worxbend/macropad/pcb/netlist.txt

+1V1           U1.6 U1.23 U1.39 U1.50 C2.1 C5.1 C8.1 C12.1 L1.1 C13.1 TP6.1
+3V3           U1.1 U1.11 U1.20 U1.30 U1.38 U1.45 U1.44 U1.49 U1.53 U1.54 C1.1 C3.1 C4.1 C6.1 C7.1 C9.1 C10.1 C32.1 C33.1 C11.1 R1.2 R3.1 U2.5 C18.1 TP5.1 R10.2 R11.2 R12.2 R13.2 J2.3 C19.1 U4.1 U4.5 C20.1
+5V            F1.2 U2.1 U2.3 C17.1 TP4.1 U4.6 C21.1 C22.1 C23.1 LED1.2 C24.1 LED2.2 C25.1 LED3.2 C26.1 LED4.2 C27.1 LED5.2 C28.1 LED6.2 C29.1 LED7.2 C30.1 LED8.2 C31.1
BOOT           R4.2 SW13.1
CC1            J1.A5 R5.1
CC2            J1.B5 R6.1
DISP_CS        U1.36 J2.5
DISP_MOSI      U1.35 J2.1
DISP_SCK       U1.34 J2.2
ENC_L_A        U1.41 ENC1.A R10.1
ENC_L_B        U1.42 ENC1.B R11.1
ENC_L_SW       U1.43 ENC1.S1
ENC_R_A        U1.2 ENC2.A R12.1
ENC_R_B        U1.3 ENC2.B R13.1
ENC_R_SW       U1.4 ENC2.S1
GND            U1.47 U1.61 C1.2 C2.2 C3.2 C4.2 C5.2 C6.2 C7.2 C8.2 C9.2 C10.2 C32.2 C33.2 C11.2 C12.2 C13.2 C14.2 Y1.2 Y1.4 C15.2 C16.2 SW14.2 SW13.2 TP3.1 J1.A1 J1.A12 J1.B1 J1.B12 J1.S1 R5.2 R6.2 U3.2 U2.2 C17.2 C18.2 SW1.2 SW2.2 SW3.2 SW4.2 SW5.2 SW6.2 SW7.2 SW8.2 SW9.2 SW10.2 SW11.2 SW12.2 ENC1.C ENC1.S2 ENC1.MP ENC2.C ENC2.S2 ENC2.MP J2.4 C19.2 U4.2 C20.2 C21.2 C22.2 C23.2 LED1.4 C24.2 LED2.4 C25.2 LED3.4 C26.2 LED4.4 C27.2 LED5.4 C28.2 LED6.4 C29.2 LED7.4 C30.2 LED8.4 C31.2 H1.1
KEY0           U1.33 SW1.1
KEY1           U1.32 SW2.1
KEY10          U1.12 SW11.1
KEY11          U1.10 SW12.1
KEY2           U1.7 SW3.1
KEY3           U1.5 SW4.1
KEY4           U1.31 SW5.1
KEY5           U1.29 SW6.1
KEY6           U1.9 SW7.1
KEY7           U1.8 SW8.1
KEY8           U1.28 SW9.1
KEY9           U1.27 SW10.1
LED_D0         R9.2 LED1.1
LED_D1         LED1.3 LED2.1
LED_D2         LED2.3 LED3.1
LED_D3         LED3.3 LED4.1
LED_D4         LED4.3 LED5.1
LED_D5         LED5.3 LED6.1
LED_D6         LED6.3 LED7.1
LED_D7         LED7.3 LED8.1
LED_DATA_3V3   U1.13 U4.3
LED_DATA_5V    U4.4 R9.1
QSPI_SS        U1.60 R4.1
RUN            U1.26 R3.2 SW14.1
SWCLK          U1.24 TP1.1
SWDIO          U1.25 TP2.1
USB_DM         U1.51 R7.2
USB_DP         U1.52 R8.2
USB_D_N        J1.A7 J1.B7 U3.1 U3.6 R7.1
USB_D_P        J1.A6 J1.B6 U3.3 U3.4 R8.1
VBUS           J1.A4 J1.A9 J1.B4 J1.B9 U3.5 F1.1
VREG_AVDD      U1.46 C14.1 R1.1
VREG_LX        U1.48 L1.2
XIN            U1.21 Y1.1 C15.1
XOUT           U1.22 R2.1
XTAL_DRIVE     Y1.3 C16.1 R2.2
