worxbend/macropad/cad/exports/drawings/general_arrangement.pdf

## TOP

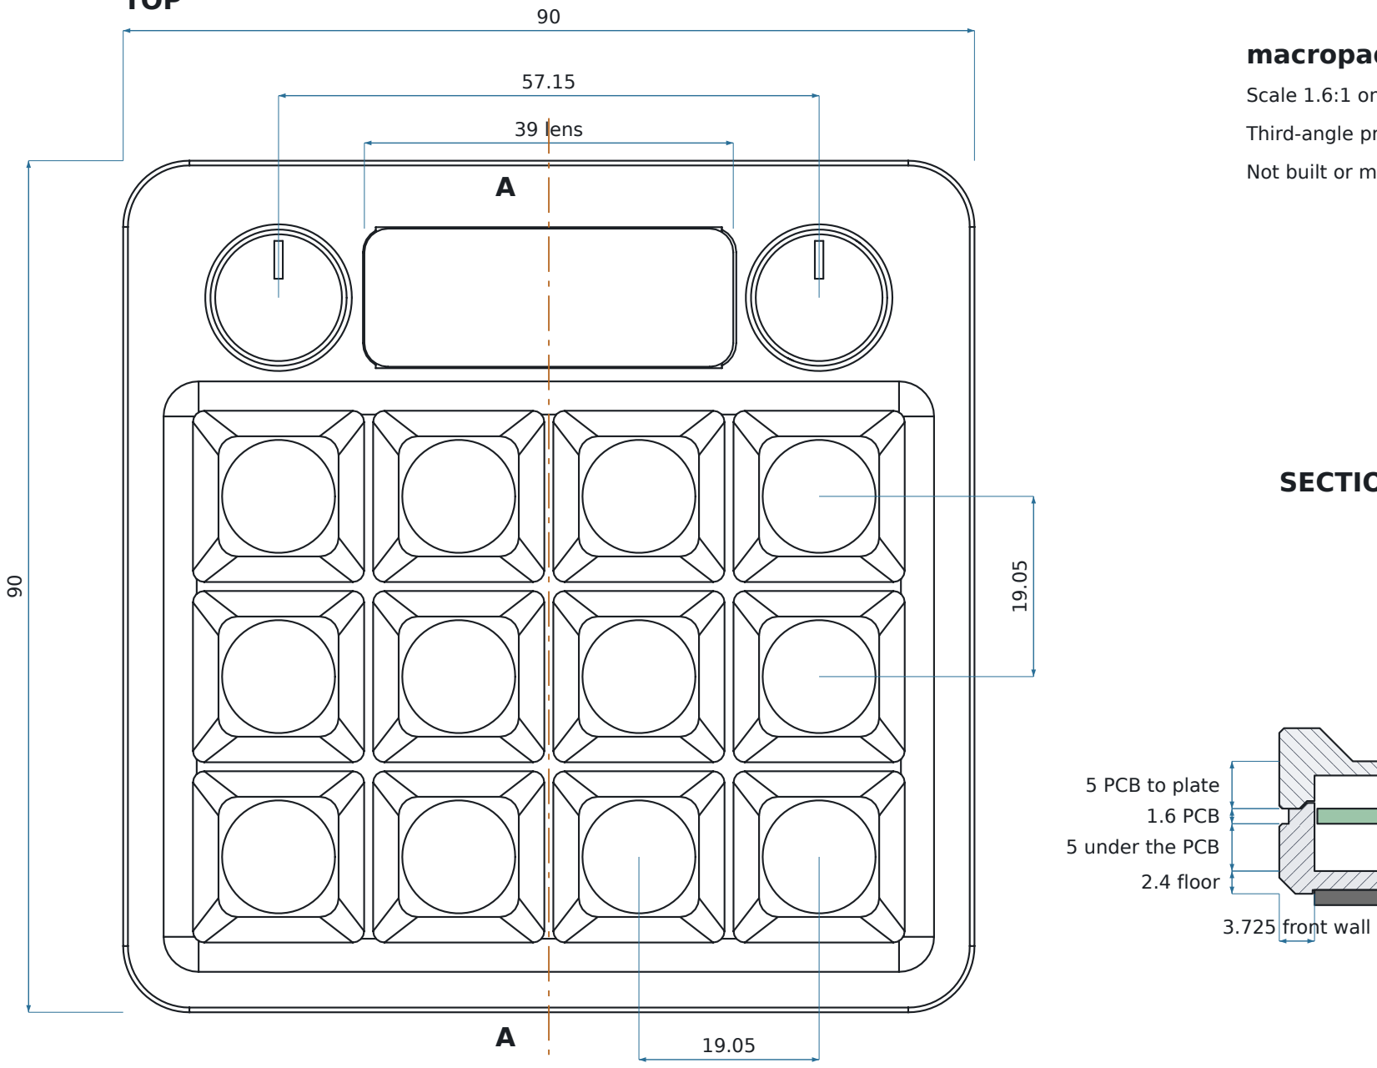
[picture p31: figure]
39 lens; 2.4 floor; 5 under the PCB; 5 PCB to plate 1.6 PCB; 3.725 front wall
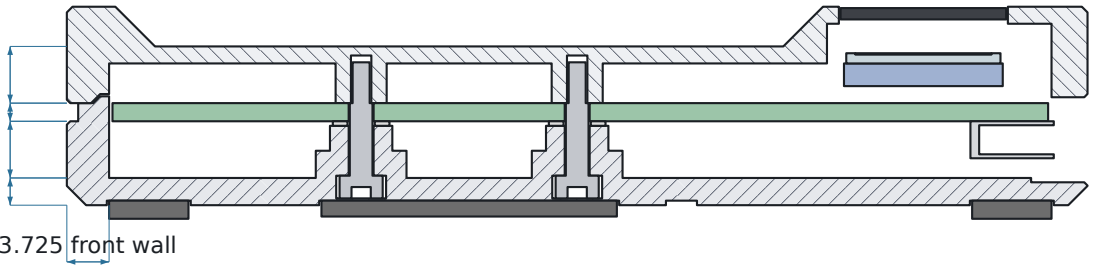
[picture p32: figure]

FRONT | RIGHT

## SECTION A-A (through the USB port, the lens and two screws)

## macropad case, general arrangement

Scale 1.6:1 on A3. Dimensions in mm, computed from board.toml and spec.py.

Third-angle projection. Print variant shown, keys not pressed. Heights in FRONT are from the desk.

Not built or measured yet: values tagged MEASURE in the sources are from datasheets.

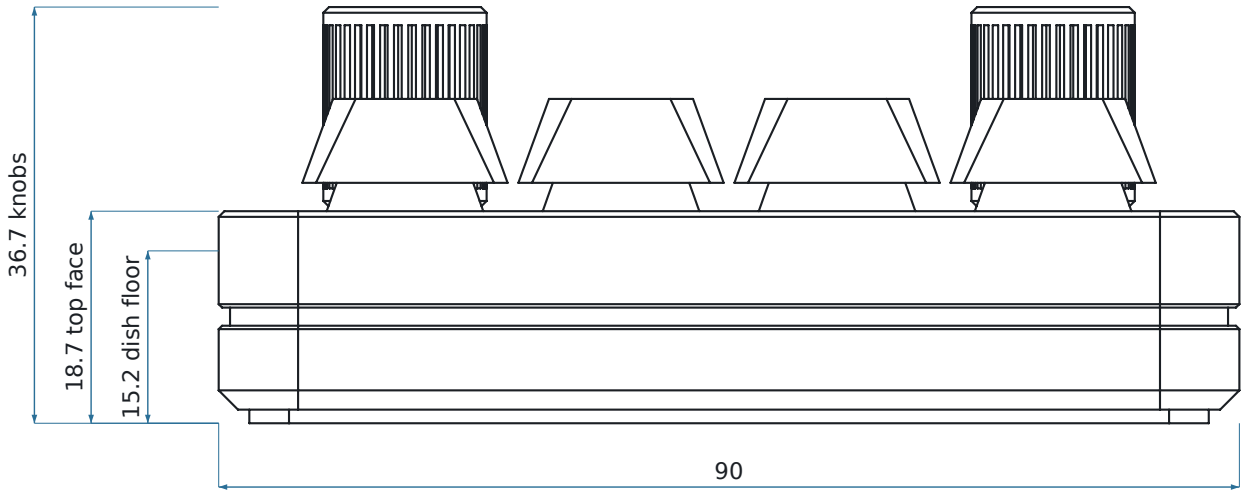
[picture p33: figure]
15.2 dish floor; 18.7 top face; 36.7 knobs
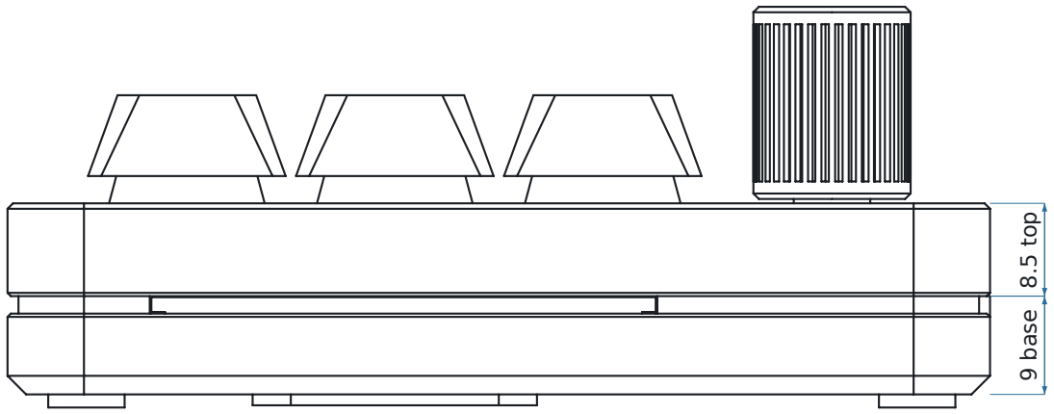
[picture p34: figure]
9 base 8.5 top
