worxbend/macropad/pcb/fab/bom-jlcpcb.csv

Comment | Designator | Footprint | LCSC Part #
100nF | C1,C2,C3,C4,C6,C7,C8,C9,C10,C32,C33,C20,C21,C24,C25,C26,C27,C28,C29,C30,C31 | C_0402_1005Metric | C1525
10k | R3 | R_0402_1005Metric | C25744
10uF | C18 | C_0603_1608Metric | C19702
12MHz | Y1 | Crystal_SMD_3225-4Pin_3.2x2.5mm | C20625731
15pF | C15,C16 | C_0402_1005Metric | C1548
1k | R2,R4 | R_0402_1005Metric | C11702
1uF | C19 | C_0402_1005Metric | C52923
2.2uF | C17,C22,C23 | C_0603_1608Metric | C23630
27R | R7,R8 | R_0402_1005Metric | C25100
3.3k | R10,R11,R12,R13 | R_0402_1005Metric | C25890
3.3uH | L1 | L_Abracon_AOTA-B201610 | C42411119
330R | R9 | R_0402_1005Metric | C25104
33R | R1 | R_0402_1005Metric | C25105
4.7uF | C5 | C_0402_1005Metric | C23733
4.7uF | C11,C12,C14 | C_0402_1005Metric_Wide | C23733
5.1k | R5,R6 | R_0402_1005Metric | C25905
74LVC1T45 | U4 | SOT-23-6 | C168856
AP2112K-3.3 | U2 | SOT-23-5 | C51118
MX hot-swap | SW1,SW2,SW3,SW4,SW5,SW6,SW7,SW8,SW9,SW10,SW11,SW12 | MX_Hotswap | C49352235
RP2354A | U1 | QFN-60-1EP_7x7mm_P0.4mm_EP3.4x3.4mm_ViaWindows | C41378174
SK6812SIDE-A | LED1,LED2,LED3,LED4,LED5,LED6,LED7,LED8 | SK6812-side-a | C5378721
TS-1187A | SW14,SW13 | SW_Push_1P1T_XKB_TS-1187A | C318884
USB-C | J1 | USB_C_Receptacle_HRO_TYPE-C-31-M-12 | C165948
USBLC6-2SC6 | U3 | SOT-23-6 | C7519
nSMD050 | F1 | Fuse_1206_3216Metric | C69688
