worxbend/macropad/cad/exports/assembly.step

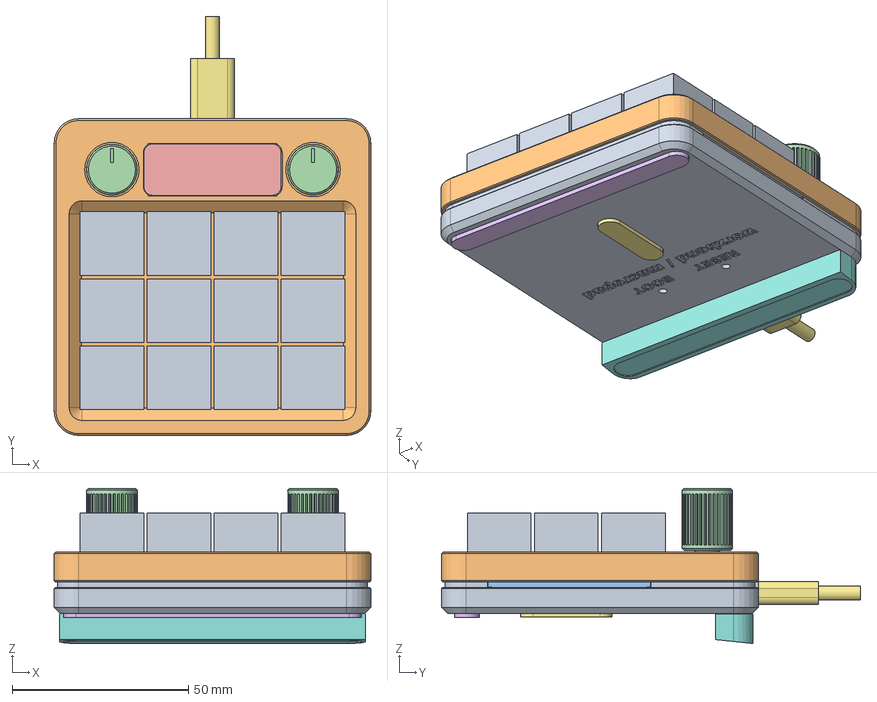
[picture p36: CAD file, 2026-11-14]
cad/exports/assembly.step
90.0 x 119.0 x 44.0 mm
base
top
diffuser_left
diffuser_right
knob_left
knob_right
lens
foot_strip_back
foot_strip_front
centre_pad
tilt_bar
pcb
display
display_glass
display_pixels
usb_receptacle
usb_plug
socket_0
socket_1
socket_2
socket_3
socket_4
socket_5
socket_6
socket_7
socket_8
socket_9
socket_10
socket_11
encoder_left
encoder_right
led_left_0
led_left_1
led_left_2
led_left_3
led_right_0
led_right_1
led_right_2
led_right_3
button_boot
button_reset
screw_0
boss_ring_0
screw_1
boss_ring_1
screw_2
boss_ring_2
screw_3
boss_ring_3
screw_4
boss_ring_4
screw_5
boss_ring_5
display_foam
switch_11 x 12
