worxbend/macropad/cad/exports/cnc/base.step

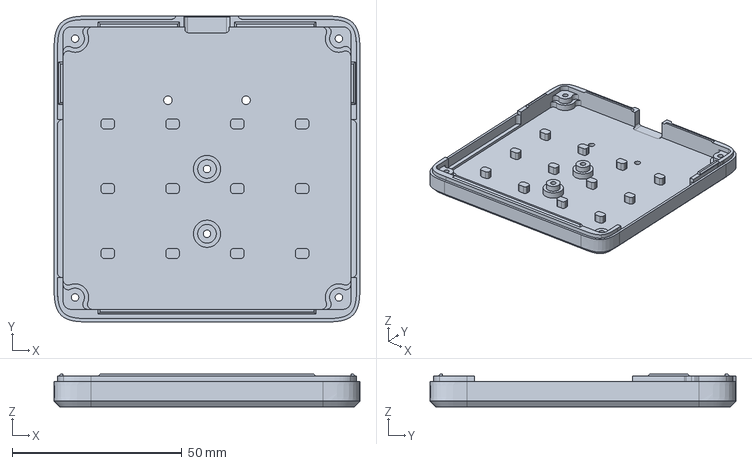
[picture p37: CAD file, 2026-11-14]
cad/exports/cnc/base.step
90.0 x 90.0 x 9.60 mm
