worxbend/macropad/cad/exports/drawings/lens.dxf

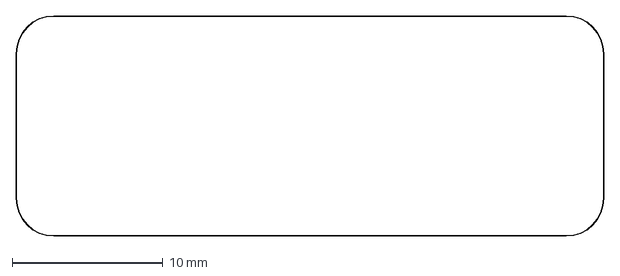
[picture p38: CAD file, 2026-11-14]
cad/exports/drawings/lens.dxf
39.0 x 14.6 mm
