worxbend/macropad/cad/exports/lens.step

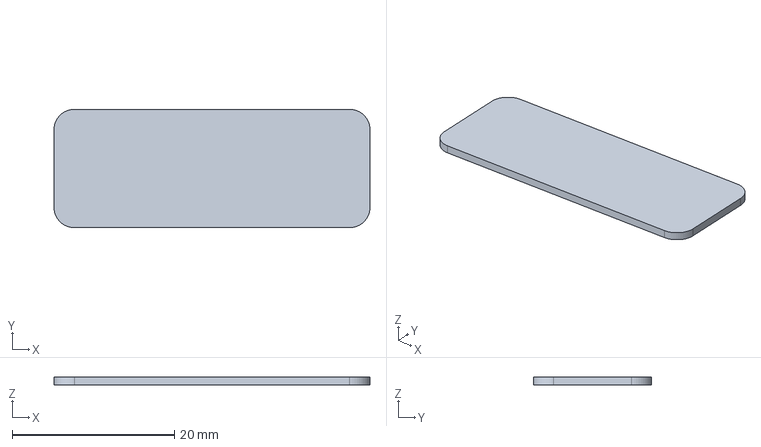
[picture p39: CAD file, 2026-11-14]
cad/exports/lens.step
39.0 x 14.6 x 1 mm
