worxbend/macropad/cad/exports/print/coupons/usb_top.stl

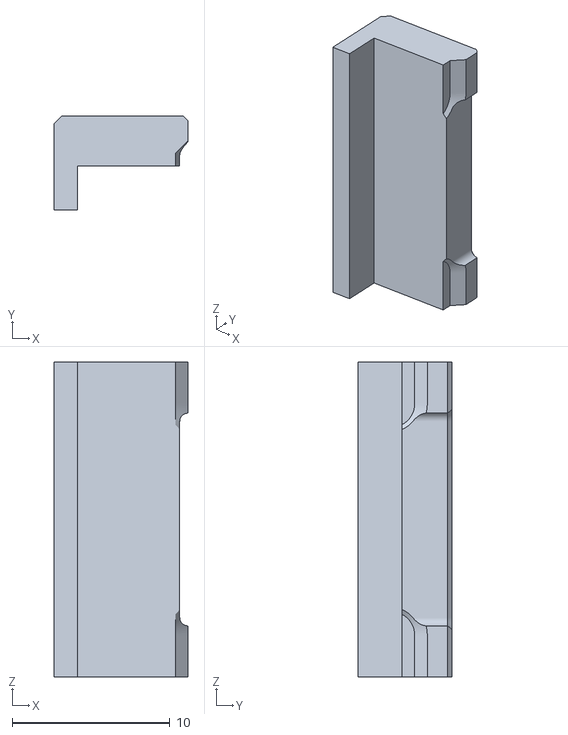
[picture p40: CAD file, 2026-11-14]
cad/exports/print/coupons/usb_top.stl
8.50 x 6.00 x 20.0
