worxbend/macropad/cad/exports/print/top.step

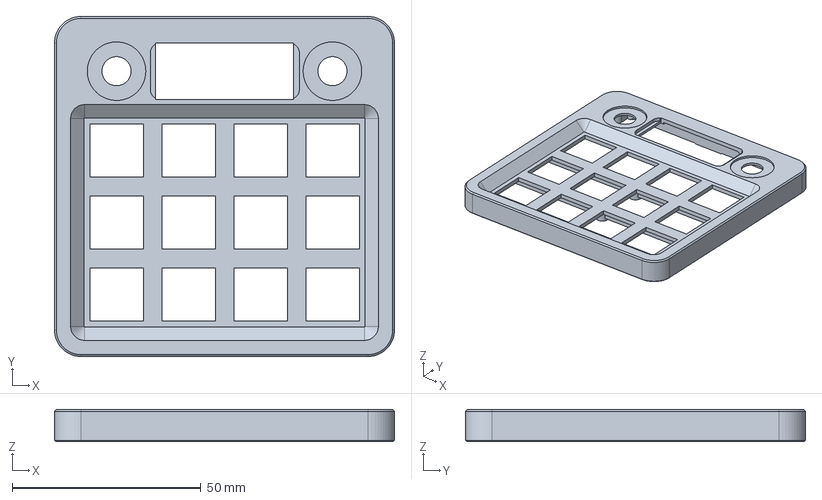
[picture p41: CAD file, 2026-11-14]
cad/exports/print/top.step
90.0 x 90.0 x 8.50 mm
