worxbend/macropad/cad/exports/drawings/lens_mask.dxf

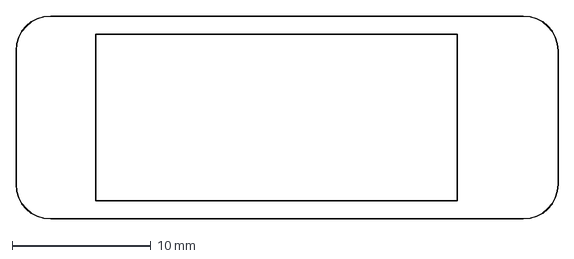
[picture p42: CAD file, 2026-11-14]
cad/exports/drawings/lens_mask.dxf
39.0 x 14.6 mm
