worxbend/macropad/cad/exports/print/coupons/lap_groove.stl

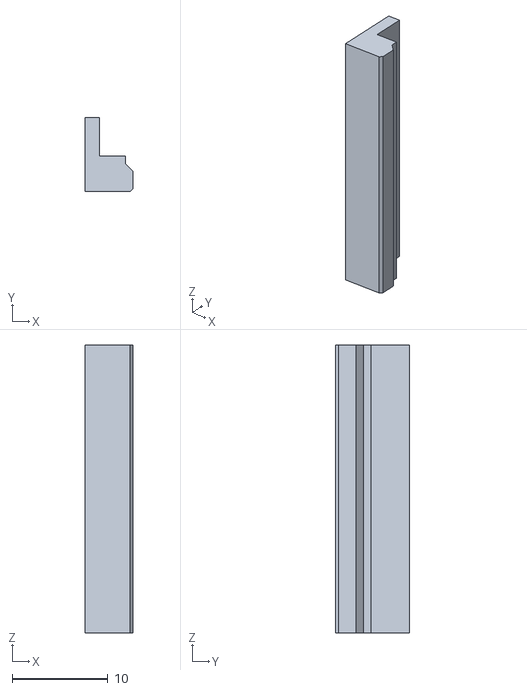
[picture p43: CAD file, 2026-11-14]
cad/exports/print/coupons/lap_groove.stl
5.00 x 7.72 x 30.0
