worxbend/macropad/cad/exports/tilt_bar.step

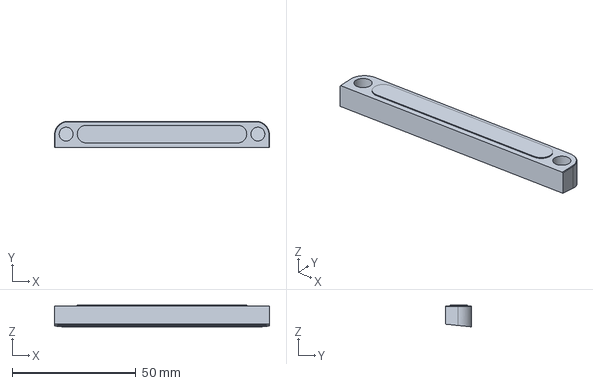
[picture p44: CAD file, 2026-11-14]
cad/exports/tilt_bar.step
87.0 x 10.7 x 8.84 mm
