worxbend/macropad/cad/exports/drawings/engraving_underside.dxf

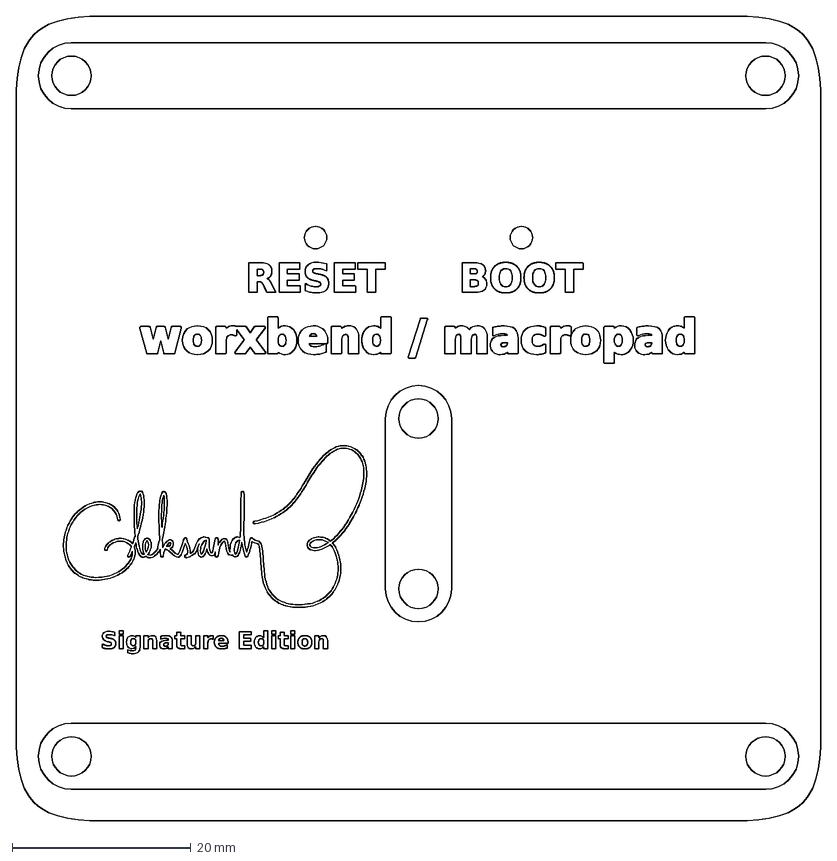
[picture p45: CAD file, 2026-11-14]
cad/exports/drawings/engraving_underside.dxf
90.0 x 90.0 mm
