worxbend/macropad/cad/exports/knob.step

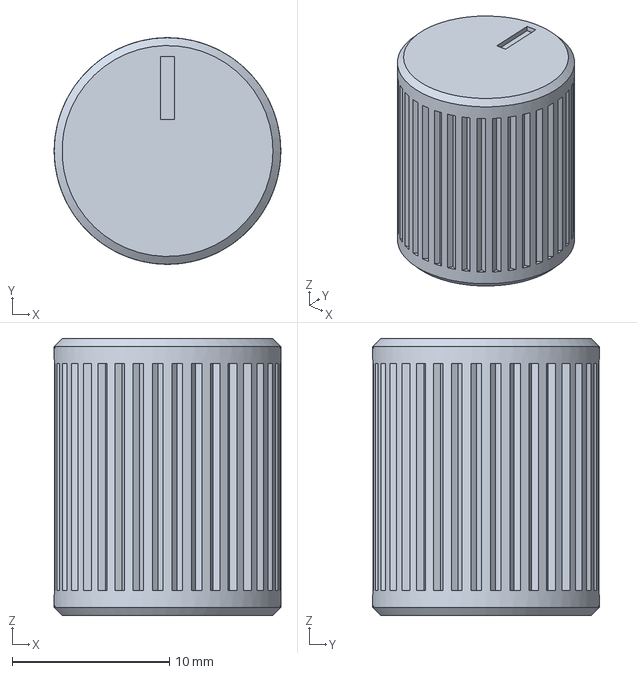
[picture p46: CAD file, 2026-11-14]
cad/exports/knob.step
14.4 x 14.4 x 17.6 mm
