worxbend/macropad/cad/exports/print/coupons/lap_ridge.stl

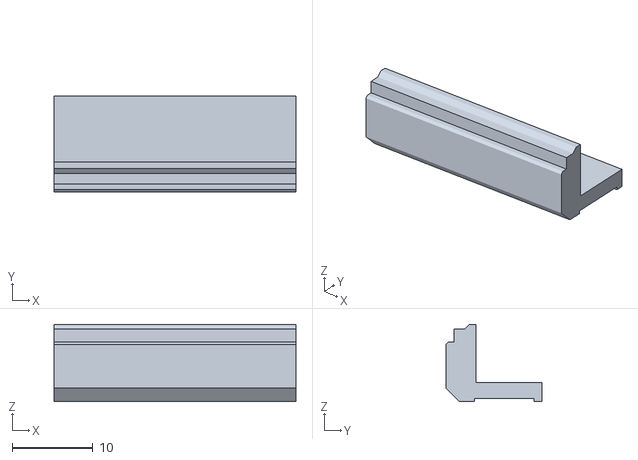
[picture p47: CAD file, 2026-11-14]
cad/exports/print/coupons/lap_ridge.stl
30.0 x 11.9 x 9.60
