worxbend/macropad/cad/exports/print/top_chairs.stl

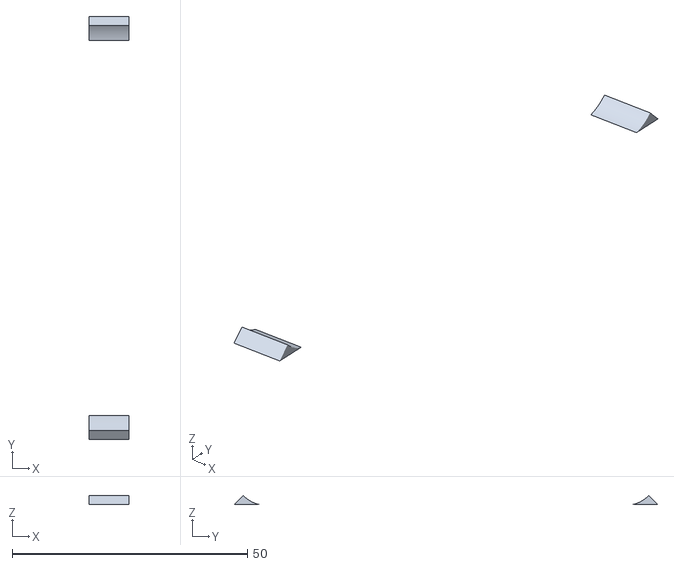
[picture p48: CAD file, 2026-11-14]
cad/exports/print/top_chairs.stl
8.50 x 90.0 x 1.87
