worxbend/macropad/cad/exports/diffuser.step

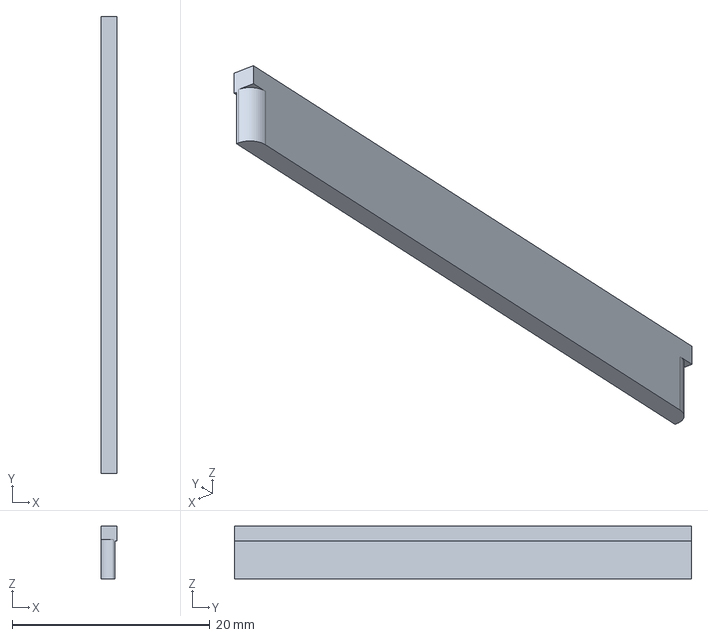
[picture p49: CAD file, 2026-11-14]
cad/exports/diffuser.step
1.60 x 46.2 x 5.35 mm
