worxbend/macropad/cad/exports/print/coupons/lens_recess_end.stl

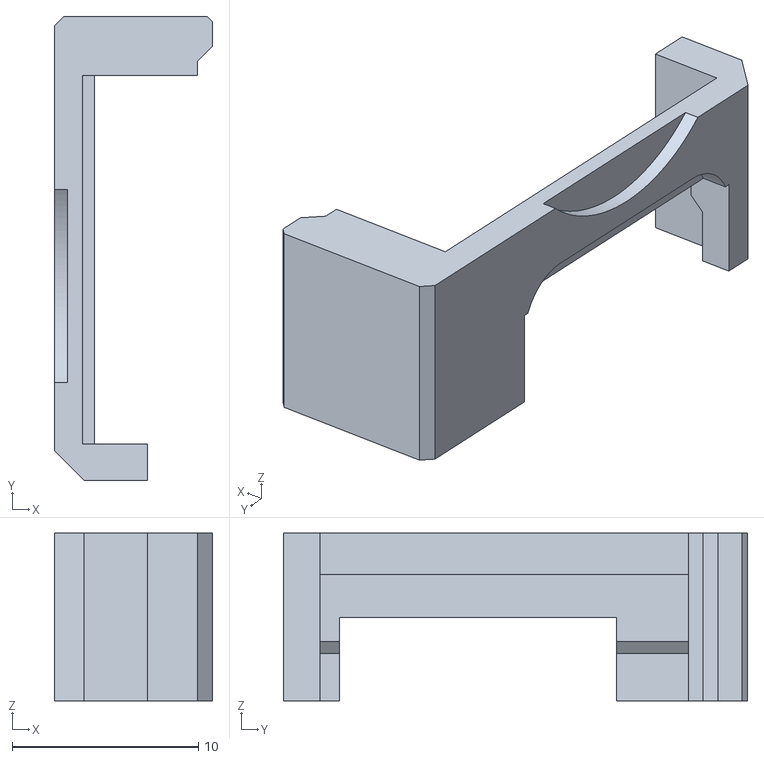
[picture p50: CAD file, 2026-11-14]
cad/exports/print/coupons/lens_recess_end.stl
8.50 x 24.9 x 9.00
