worxbend/macropad/cad/exports/centre_pad.step

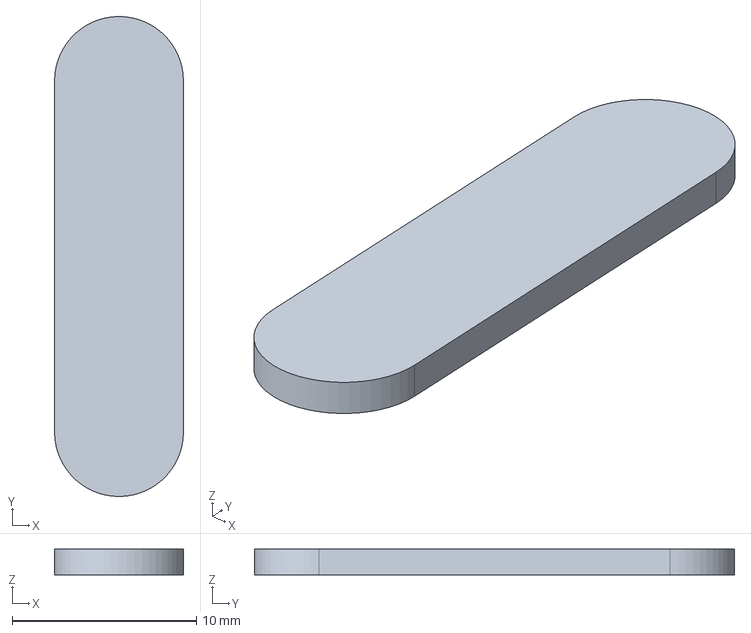
[picture p51: CAD file, 2026-11-14]
cad/exports/centre_pad.step
7.00 x 26.1 x 1.40 mm
