worxbend/macropad/cad/exports/print/coupons/pilot_holes.stl

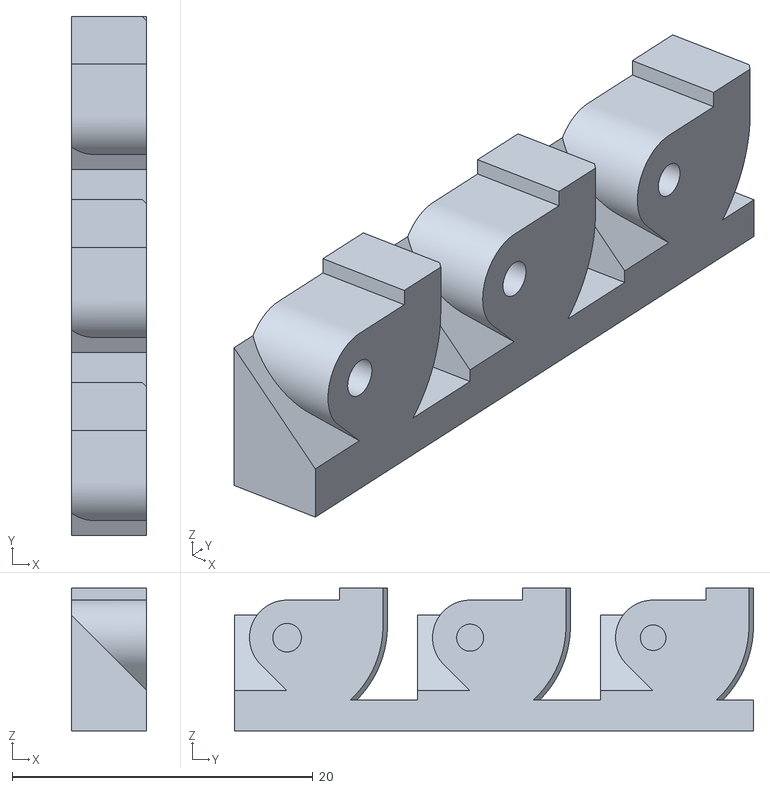
[picture p52: CAD file, 2026-11-14]
cad/exports/print/coupons/pilot_holes.stl
5.00 x 34.5 x 9.50
