worxbend/macropad/cad/exports/foot_strip.step

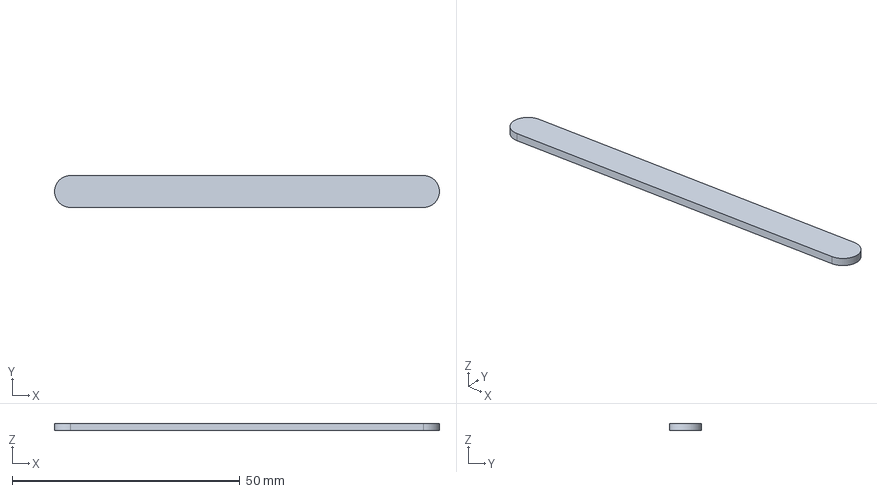
[picture p53: CAD file, 2026-11-14]
cad/exports/foot_strip.step
84.6 x 7.00 x 1.60 mm
