worxbend/macropad/cad/exports/print/coupons/usb_base.stl

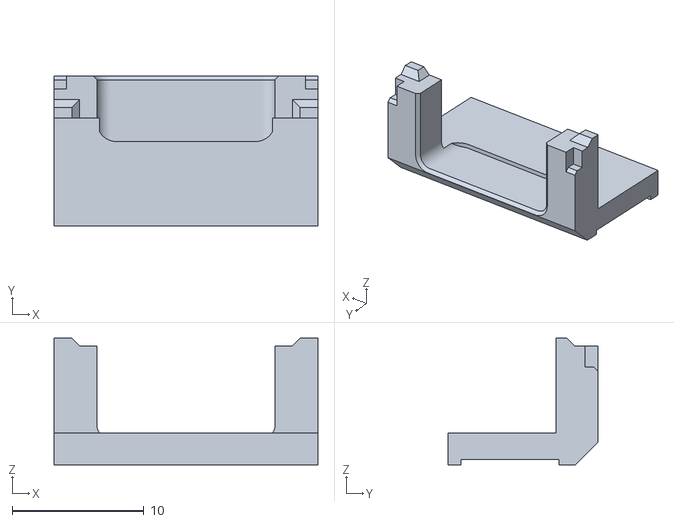
[picture p54: CAD file, 2026-11-14]
cad/exports/print/coupons/usb_base.stl
20.0 x 11.4 x 9.60
