worxbend/macropad/cad/exports/print/coupons/light_channel.stl

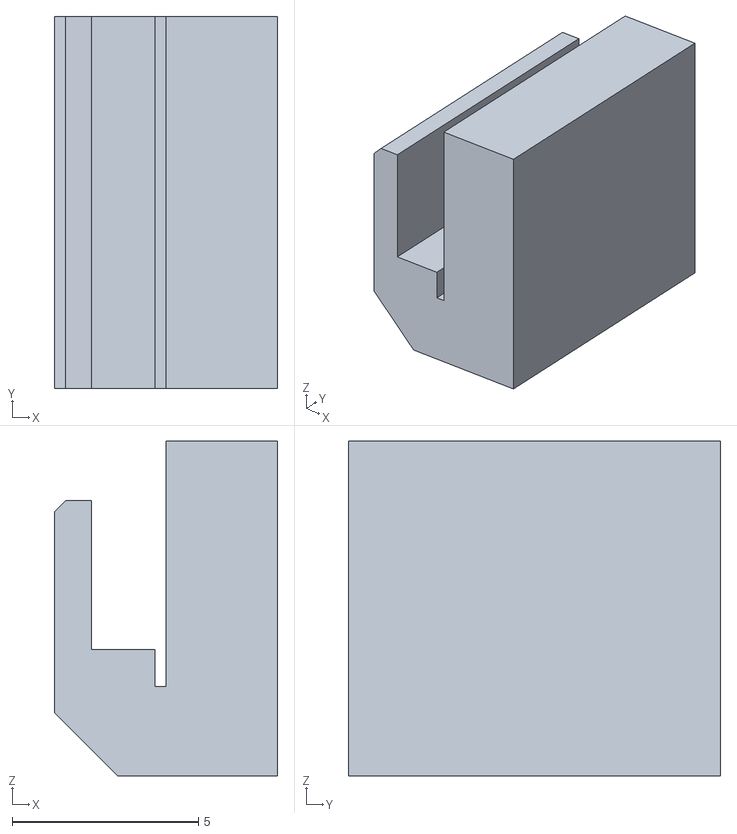
[picture p55: CAD file, 2026-11-14]
cad/exports/print/coupons/light_channel.stl
6.00 x 10.0 x 9.00
