worxbend/macropad/cad/exports/print/coupons/mx_cutout.stl

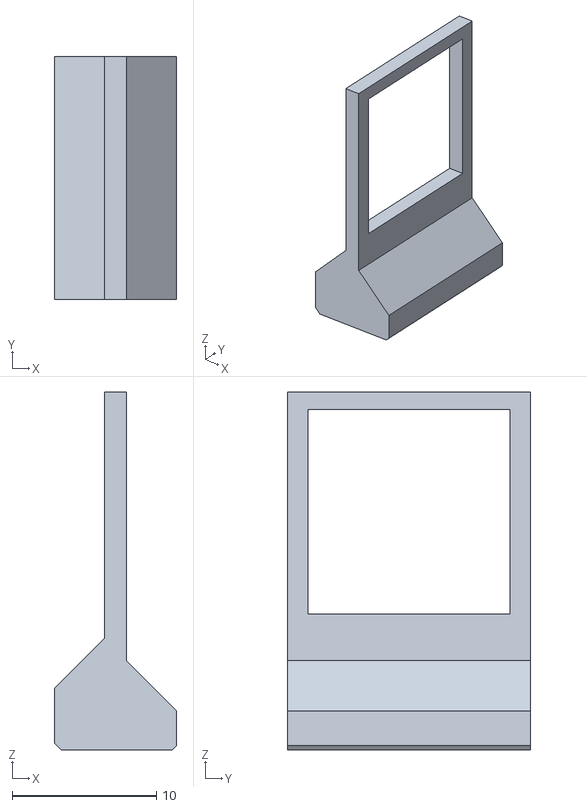
[picture p56: CAD file, 2026-11-14]
cad/exports/print/coupons/mx_cutout.stl
8.50 x 16.9 x 24.9
