worxbend/macropad/cad/exports/print/coupons/knob_bore.stl

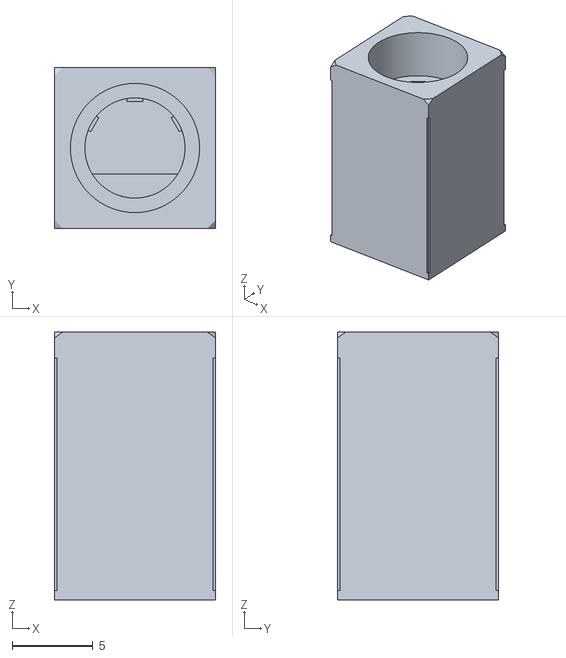
[picture p57: CAD file, 2026-11-14]
cad/exports/print/coupons/knob_bore.stl
10.0 x 10.0 x 16.6
