worxbend/macropad/(list of files, cad)

Other CAD files:
cad/exports/cnc/top.step
cad/exports/print/base.step
cad/exports/centre_pad.stl
cad/exports/cnc/base.stl
cad/exports/cnc/top.stl
cad/exports/diffuser.stl
cad/exports/foot_strip.stl
cad/exports/knob.stl
cad/exports/print/base.stl
cad/exports/print/top.stl
cad/exports/tilt_bar.stl
