worxbend/macropad/docs/images/pcb/schematic.pdf

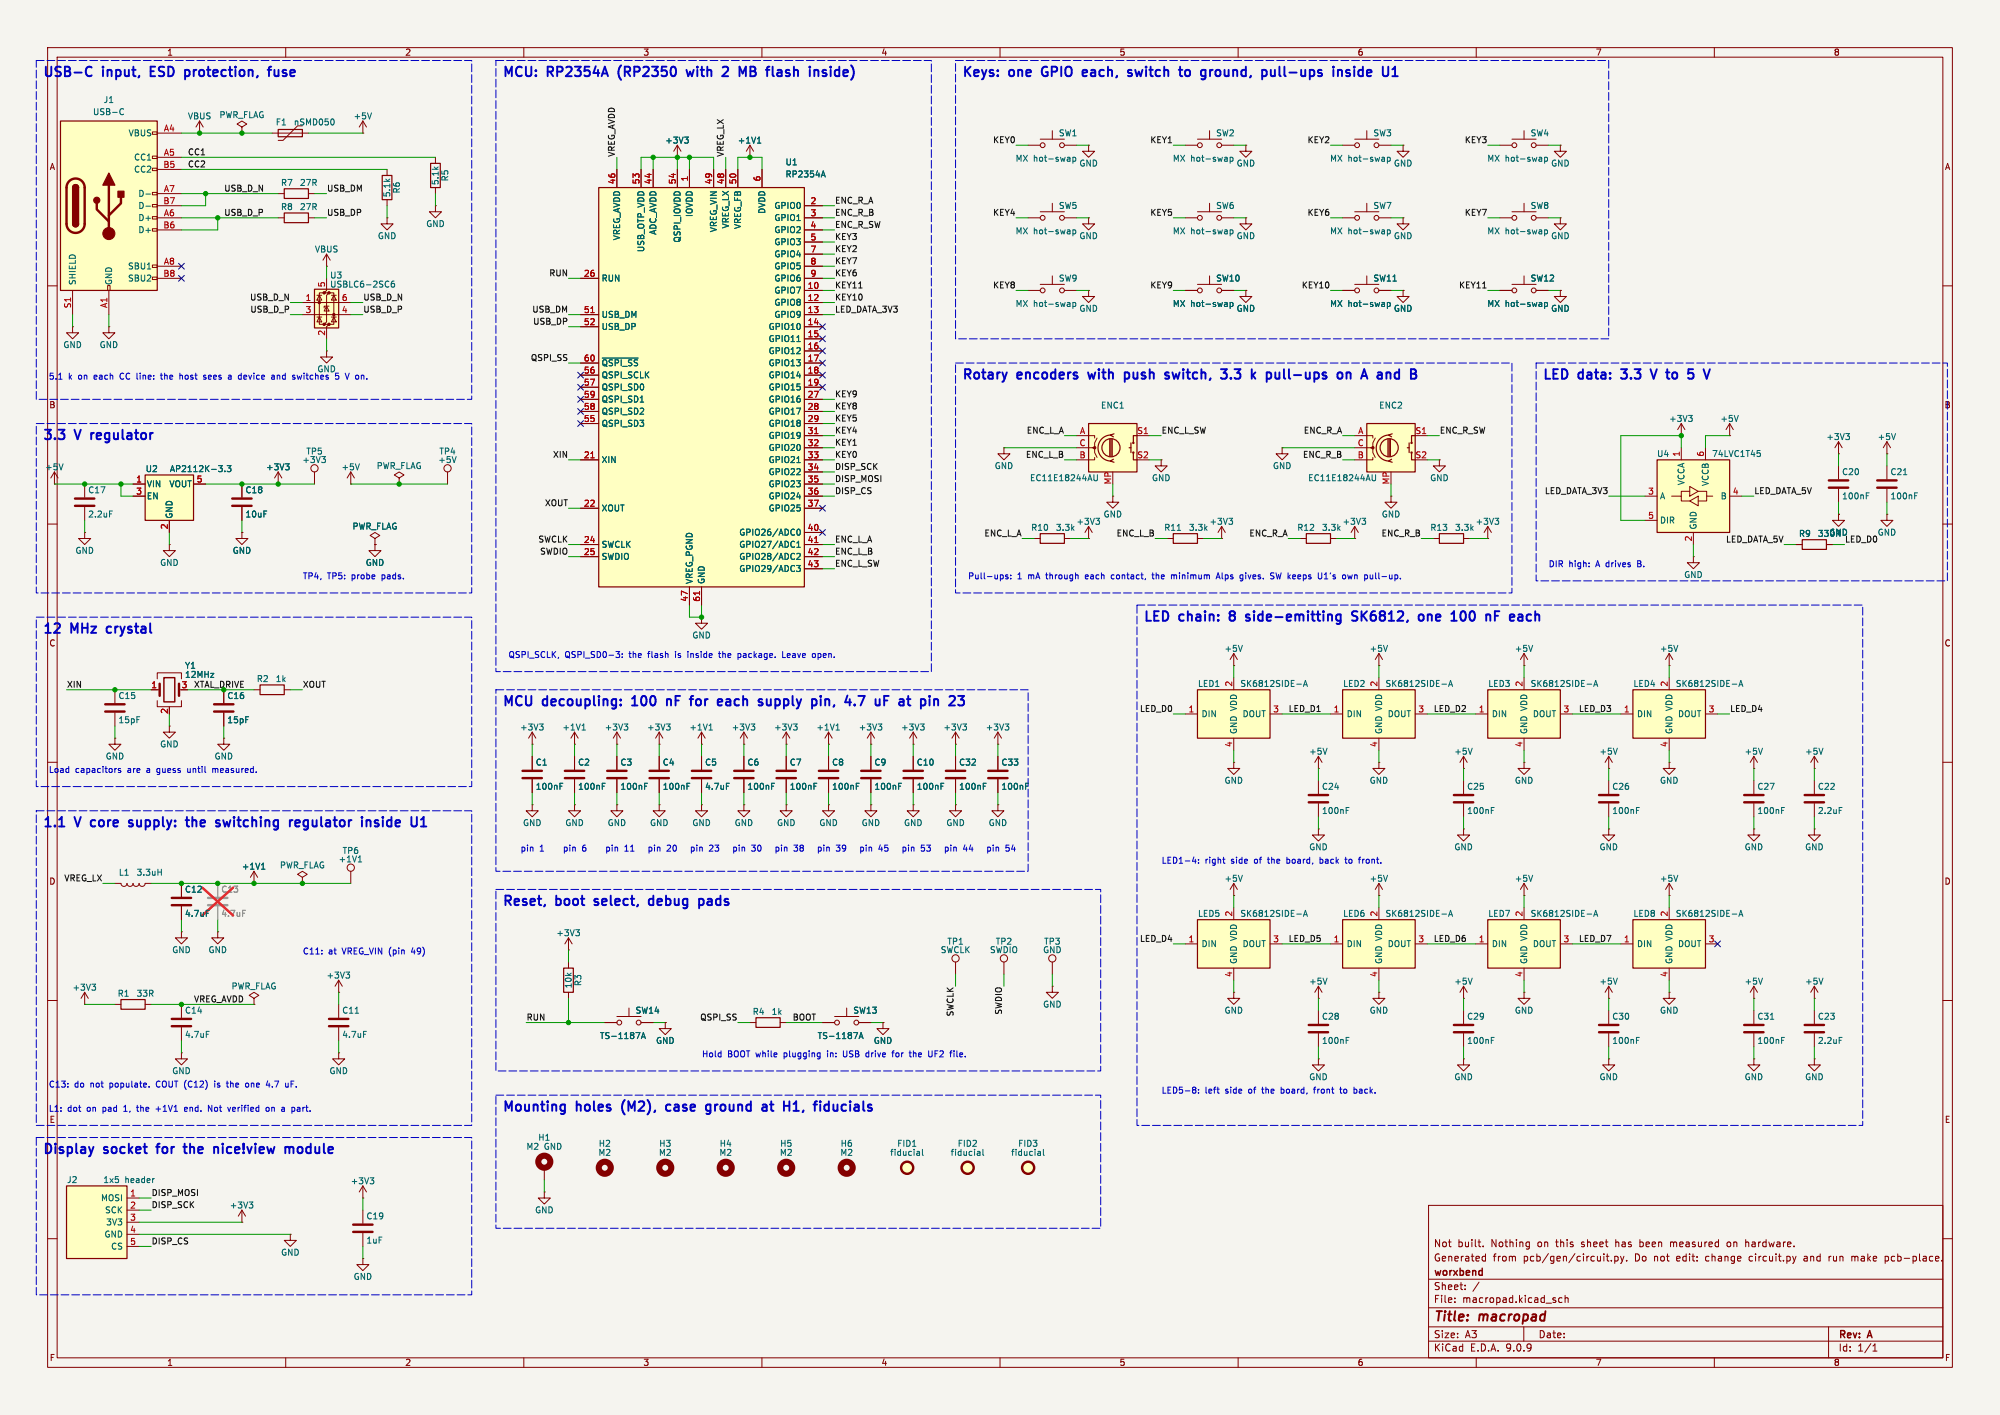
[picture p60: page 1]

SW4 MX hot-swap SW7 MX hot-swapSW11 MX hot-swap GND GND GND

6 RUN 26 USB_DM 51 USB_DP 52 ~{QSPI_SS} 60 QSPI_SCLK 56 QSPI_SD0 57 QSPI_SD1 59 QSPI_SD2 58 QSPI_SD3 55 XIN 21 XOUT 22 SWCLK 24 SWDIO 25 ADC_AVDD 44 IOVDD

SW12 MX hot-swapSW8 MX hot-swap

MCU decoupling: 100 nF for each supply pin, 4.7 uF at pin 23

Mounting holes (M2), case ground at H1, fiducials

Display socket for the nice!view module
