worxbend/macropad/pcb/kicad/macropad.kicad_pcb

## KiCad design pcb/kicad/macropad.kicad_pcb (2026-11-14)

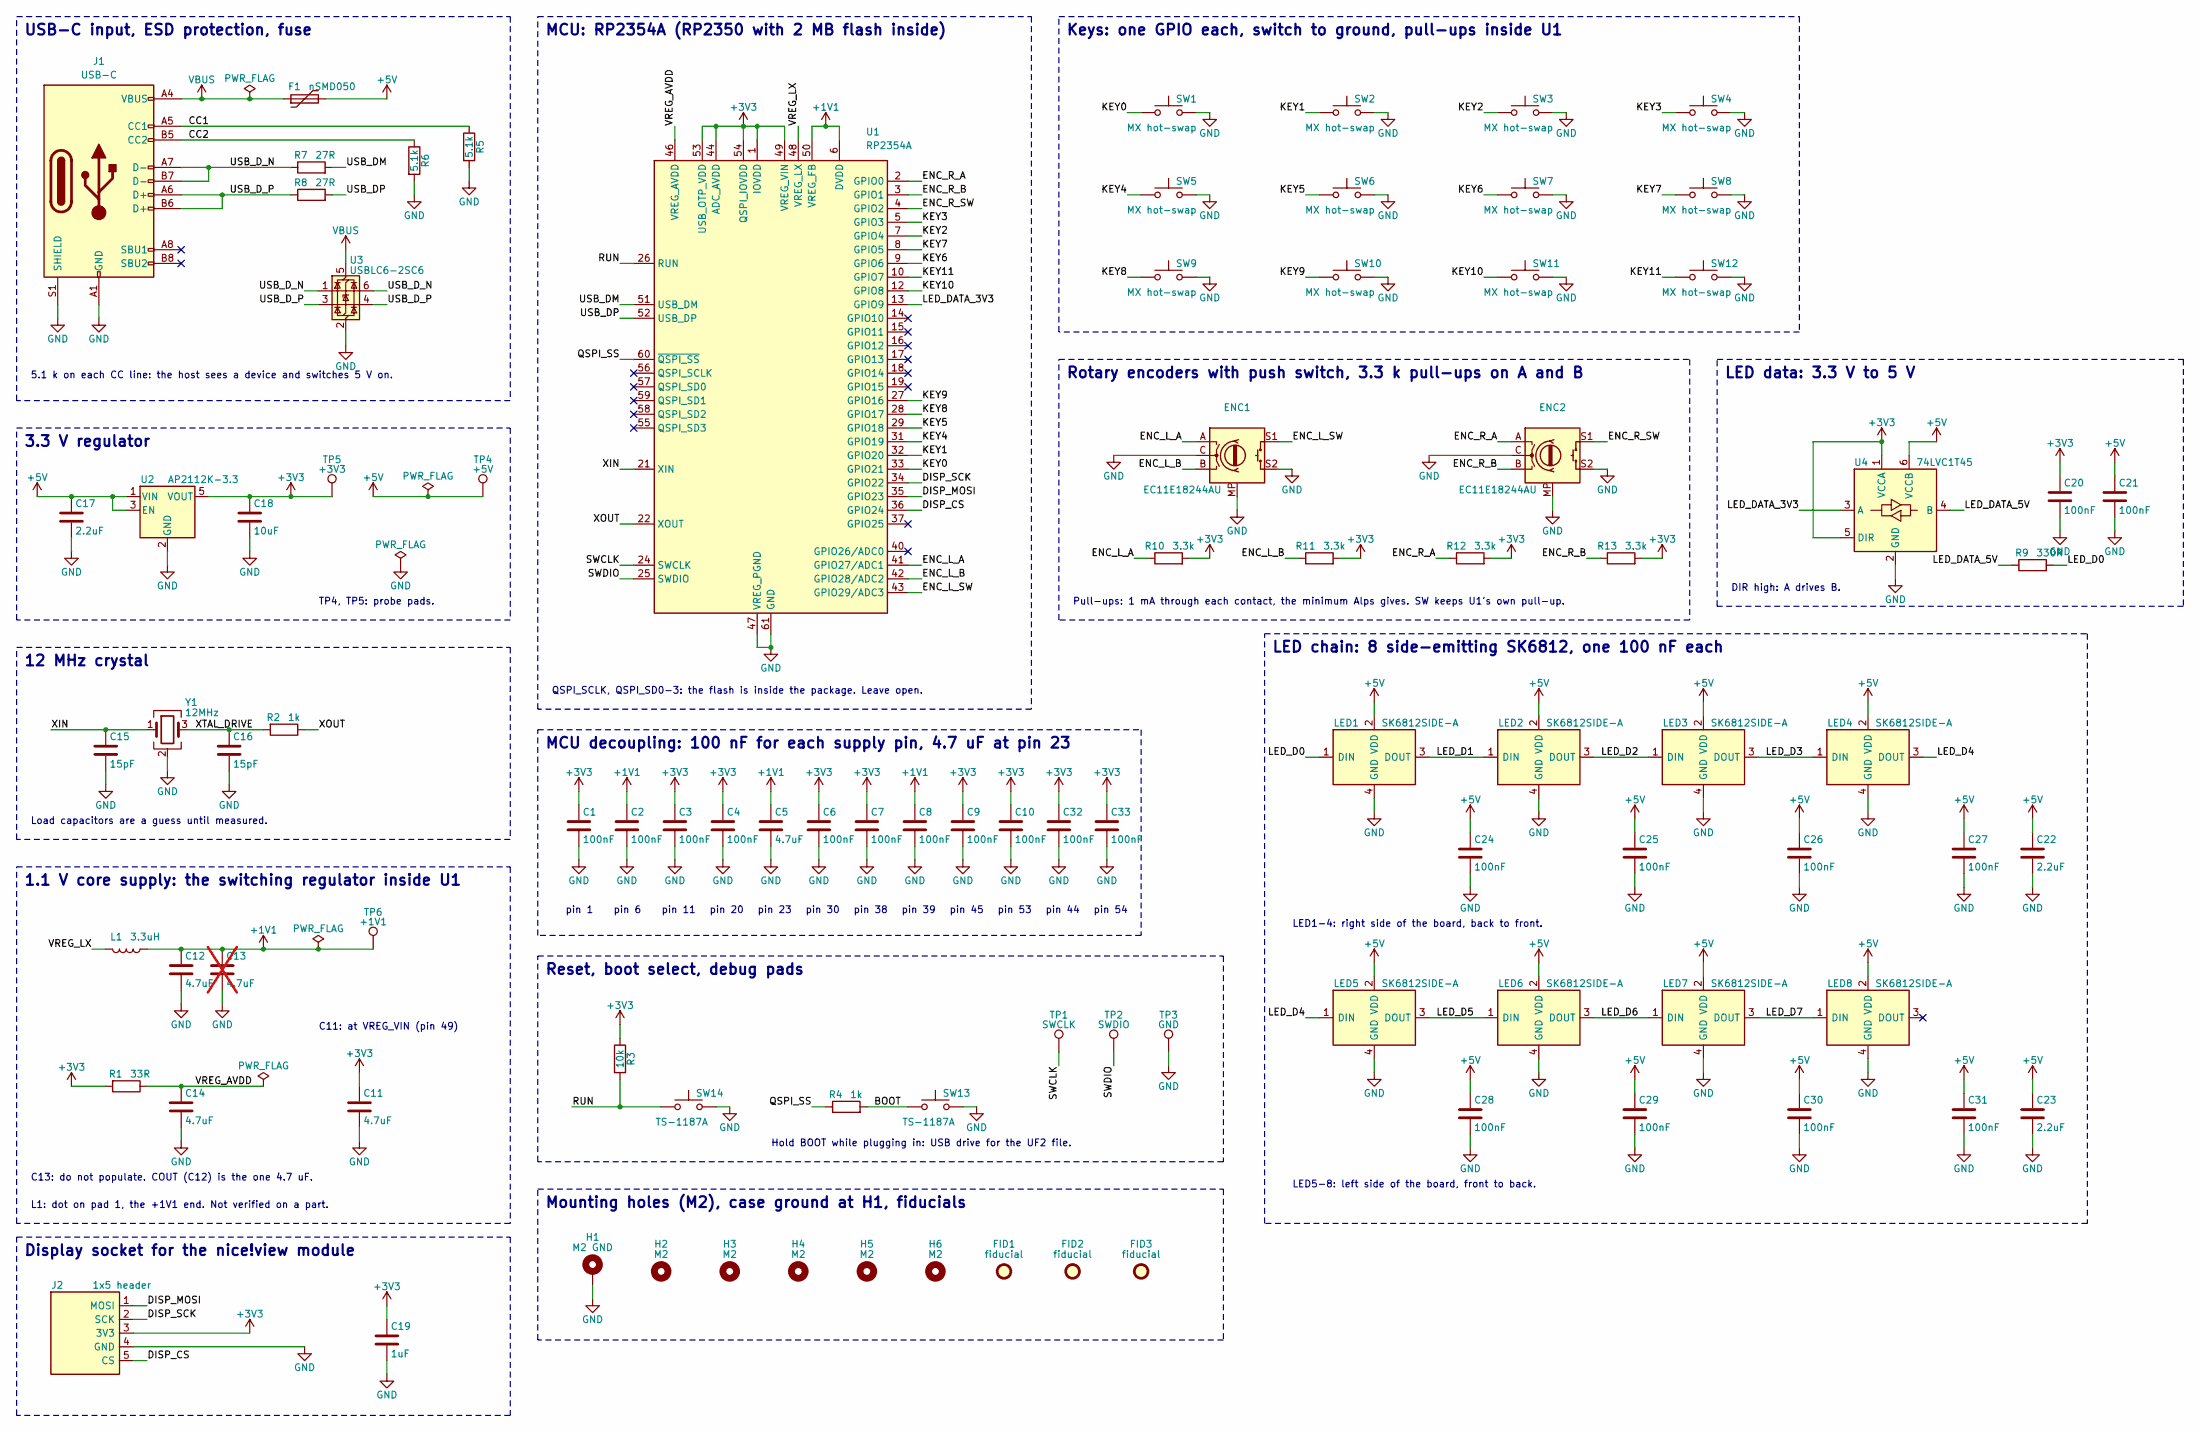
[picture p61: schematic macropad.kicad_sch]

Parts:
C1, C2, C3, C4, C6, C7, C8, C9, C10, C20, C21, C24, C25, C26, C27, C28, C29, C30, C31, C32, C33: 100nF; C_0402_1005Metric; LCSC C1525
C5: 4.7uF; C_0402_1005Metric; LCSC C23733
C11, C12, C14: 4.7uF; C_0402_1005Metric_Wide; LCSC C23733
C13: 4.7uF; C_0402_1005Metric_Wide; LCSC C23733; not fitted
C15, C16: 15pF; C_0402_1005Metric; LCSC C1548
C17, C22, C23: 2.2uF; C_0603_1608Metric; LCSC C23630
C18: 10uF; C_0603_1608Metric; LCSC C19702
C19: 1uF; C_0402_1005Metric; LCSC C52923
ENC1, ENC2: EC11E18244AU; RotaryEncoder_Alps_EC11E-Switch_Vertical_H20mm; LCSC C202365
F1: nSMD050; Fuse_1206_3216Metric; LCSC C69688
FID1, FID2, FID3: fiducial; Fiducial_1mm_Mask2mm
H1: M2 GND; Hole_M2_Ground
H2, H3, H4, H5, H6: M2; Hole_M2
J1: USB-C; USB_C_Receptacle_HRO_TYPE-C-31-M-12; LCSC C165948
J2: 1x5 header; PinSocket_1x05_P2.54mm_Vertical; LCSC C2337
L1: 3.3uH; L_Abracon_AOTA-B201610; LCSC C42411119
LED1, LED2, LED3, LED4, LED5, LED6, LED7, LED8: SK6812SIDE-A; SK6812-side-a; LCSC C5378721
R1: 33R; R_0402_1005Metric; LCSC C25105
R2, R4: 1k; R_0402_1005Metric; LCSC C11702
R3: 10k; R_0402_1005Metric; LCSC C25744
R5, R6: 5.1k; R_0402_1005Metric; LCSC C25905
R7, R8: 27R; R_0402_1005Metric; LCSC C25100
R9: 330R; R_0402_1005Metric; LCSC C25104
R10, R11, R12, R13: 3.3k; R_0402_1005Metric; LCSC C25890
SW1, SW2, SW3, SW4, SW5, SW6, SW7, SW8, SW9, SW10, SW11, SW12: MX hot-swap; MX_Hotswap; LCSC C49352235
SW13, SW14: TS-1187A; SW_Push_1P1T_XKB_TS-1187A; LCSC C318884
TP1: SWCLK; TestPoint_Pad_D1.0mm
TP2: SWDIO; TestPoint_Pad_D1.0mm
TP3: GND; TestPoint_Pad_D1.0mm
TP4: +5V; TestPoint_Pad_D1.0mm
TP5: +3V3; TestPoint_Pad_D1.0mm
TP6: +1V1; TestPoint_Pad_D1.0mm
U1: RP2354A; QFN-60-1EP_7x7mm_P0.4mm_EP3.4x3.4mm_ViaWindows; LCSC C41378174
U2: AP2112K-3.3; SOT-23-5; LCSC C51118
U3: USBLC6-2SC6; SOT-23-6; LCSC C7519
U4: 74LVC1T45; SOT-23-6; LCSC C168856
Y1: 12MHz; Crystal_SMD_3225-4Pin_3.2x2.5mm; LCSC C20625731

Connections:
+1V1: C2.1, C5.1, C8.1, C12.1, C13.1, L1.1, TP6.1, U1.6 (DVDD), U1.23 (DVDD), U1.39 (DVDD), U1.50 (VREG_FB)
+3V3: C1.1, C3.1, C4.1, C6.1, C7.1, C9.1, C10.1, C11.1, C18.1, C19.1, C20.1, C32.1, C33.1, J2.3 (3V3), R1.2, R3.1, R10.2, R11.2, R12.2, R13.2, TP5.1, U1.1 (IOVDD), U1.11 (IOVDD), U1.20 (IOVDD), U1.30 (IOVDD), U1.38 (IOVDD), U1.44 (ADC_AVDD), U1.45 (IOVDD), U1.49 (VREG_VIN), U1.53 (USB_OTP_VDD), U1.54 (QSPI_IOVDD), U2.5 (VOUT), U4.1 (VCCA), U4.5 (DIR)
+5V: C17.1, C21.1, C22.1, C23.1, C24.1, C25.1, C26.1, C27.1, C28.1, C29.1, C30.1, C31.1, F1.2, LED1.2 (VDD), LED2.2 (VDD), LED3.2 (VDD), LED4.2 (VDD), LED5.2 (VDD), LED6.2 (VDD), LED7.2 (VDD), LED8.2 (VDD), TP4.1, U2.1 (VIN), U2.3 (EN), U4.6 (VCCB)
/BOOT: R4.2, SW13.1
/CC1: J1.A5 (CC1), R5.1
/CC2: J1.B5 (CC2), R6.1
/DISP_CS: J2.5 (CS), U1.36 (GPIO24)
/DISP_MOSI: J2.1 (MOSI), U1.35 (GPIO23)
/DISP_SCK: J2.2 (SCK), U1.34 (GPIO22)
/ENC_L_A: ENC1.A, R10.1, U1.41 (GPIO27/ADC1)
/ENC_L_B: ENC1.B, R11.1, U1.42 (GPIO28/ADC2)
/ENC_L_SW: ENC1.S1, U1.43 (GPIO29/ADC3)
/ENC_R_A: ENC2.A, R12.1, U1.2 (GPIO0)
/ENC_R_B: ENC2.B, R13.1, U1.3 (GPIO1)
/ENC_R_SW: ENC2.S1, U1.4 (GPIO2)
/KEY0: SW1.1, U1.33 (GPIO21)
/KEY1: SW2.1, U1.32 (GPIO20)
/KEY2: SW3.1, U1.7 (GPIO4)
/KEY3: SW4.1, U1.5 (GPIO3)
/KEY4: SW5.1, U1.31 (GPIO19)
/KEY5: SW6.1, U1.29 (GPIO18)
/KEY6: SW7.1, U1.9 (GPIO6)
/KEY7: SW8.1, U1.8 (GPIO5)
/KEY8: SW9.1, U1.28 (GPIO17)
/KEY9: SW10.1, U1.27 (GPIO16)
/KEY10: SW11.1, U1.12 (GPIO8)
/KEY11: SW12.1, U1.10 (GPIO7)
/LED_D0: LED1.1 (DIN), R9.2
/LED_D1: LED1.3 (DOUT), LED2.1 (DIN)
/LED_D2: LED2.3 (DOUT), LED3.1 (DIN)
/LED_D3: LED3.3 (DOUT), LED4.1 (DIN)
/LED_D4: LED4.3 (DOUT), LED5.1 (DIN)
/LED_D5: LED5.3 (DOUT), LED6.1 (DIN)
/LED_D6: LED6.3 (DOUT), LED7.1 (DIN)
/LED_D7: LED7.3 (DOUT), LED8.1 (DIN)
/LED_DATA_3V3: U1.13 (GPIO9), U4.3 (A)
/LED_DATA_5V: R9.1, U4.4 (B)
/QSPI_SS: R4.1, U1.60 (~QSPI_SS)
/RUN: R3.2, SW14.1, U1.26 (RUN)
/SWCLK: TP1.1, U1.24 (SWCLK)
/SWDIO: TP2.1, U1.25 (SWDIO)
/USB_DM: R7.2, U1.51 (USB_DM)
/USB_DP: R8.2, U1.52 (USB_DP)
/USB_D_N: J1.A7 (D-), J1.B7 (D-), R7.1, U3.1 (I/O1), U3.6 (I/O1)
/USB_D_P: J1.A6 (D+), J1.B6 (D+), R8.1, U3.3 (I/O2), U3.4 (I/O2)
/VREG_AVDD: C14.1, R1.1, U1.46 (VREG_AVDD)
/VREG_LX: L1.2, U1.48 (VREG_LX)
/XIN: C15.1, U1.21 (XIN), Y1.1
/XOUT: R2.1, U1.22 (XOUT)
/XTAL_DRIVE: C16.1, R2.2, Y1.3
GND: C1.2, C2.2, C3.2, C4.2, C5.2, C6.2, C7.2, C8.2, C9.2, C10.2, C11.2, C12.2, C13.2, C14.2, C15.2, C16.2, C17.2, C18.2, C19.2, C20.2, C21.2, C22.2, C23.2, C24.2, C25.2, C26.2, C27.2, C28.2, C29.2, C30.2, C31.2, C32.2, C33.2, ENC1.C, ENC1.MP, ENC1.S2, ENC2.C, ENC2.MP, ENC2.S2, H1.1, J1.A1 (GND), J1.A12 (GND), J1.B1 (GND), J1.B12 (GND), J1.S1 (SHIELD), J2.4 (GND), LED1.4 (GND), LED2.4 (GND), LED3.4 (GND), LED4.4 (GND), LED5.4 (GND), LED6.4 (GND), LED7.4 (GND), LED8.4 (GND), R5.2, R6.2, SW1.2, SW2.2, SW3.2, SW4.2, SW5.2, SW6.2, SW7.2, SW8.2, SW9.2, SW10.2, SW11.2, SW12.2, SW13.2, SW14.2, TP3.1, U1.47 (VREG_PGND), U1.61 (GND), U2.2 (GND), U3.2 (GND), U4.2 (GND), Y1.2 (G), Y1.4 (G)
VBUS: F1.1, J1.A4 (VBUS), J1.A9 (VBUS), J1.B4 (VBUS), J1.B9 (VBUS), U3.5 (VBUS)

Notes on the sheet:
USB-C input, ESD protection, fuse
5.1 k on each CC line: the host sees a device and switches 5 V on.
3.3 V regulator
TP4, TP5: probe pads.
12 MHz crystal
Load capacitors are a guess until measured.
1.1 V core supply: the switching regulator inside U1
C11: at VREG_VIN (pin 49)
C13: do not populate. COUT (C12) is the one 4.7 uF.
L1: dot on pad 1, the +1V1 end. Not verified on a part.
Display socket for the nice!view module
MCU: RP2354A (RP2350 with 2 MB flash inside)
QSPI_SCLK, QSPI_SD0-3: the flash is inside the package. Leave open.
MCU decoupling: 100 nF for each supply pin, 4.7 uF at pin 23
pin 1
pin 6
pin 11
pin 20
pin 23
pin 30
pin 38
pin 39
pin 45
pin 53
pin 44
pin 54
Reset, boot select, debug pads
Hold BOOT while plugging in: USB drive for the UF2 file.
Mounting holes (M2), case ground at H1, fiducials
Keys: one GPIO each, switch to ground, pull-ups inside U1
Rotary encoders with push switch, 3.3 k pull-ups on A and B
Pull-ups: 1 mA through each contact, the minimum Alps gives. SW keeps U1's own pull-up.
LED data: 3.3 V to 5 V
DIR high: A drives B.
LED chain: 8 side-emitting SK6812, one 100 nF each
LED1-4: right side of the board, back to front.
LED5-8: left side of the board, front to back.

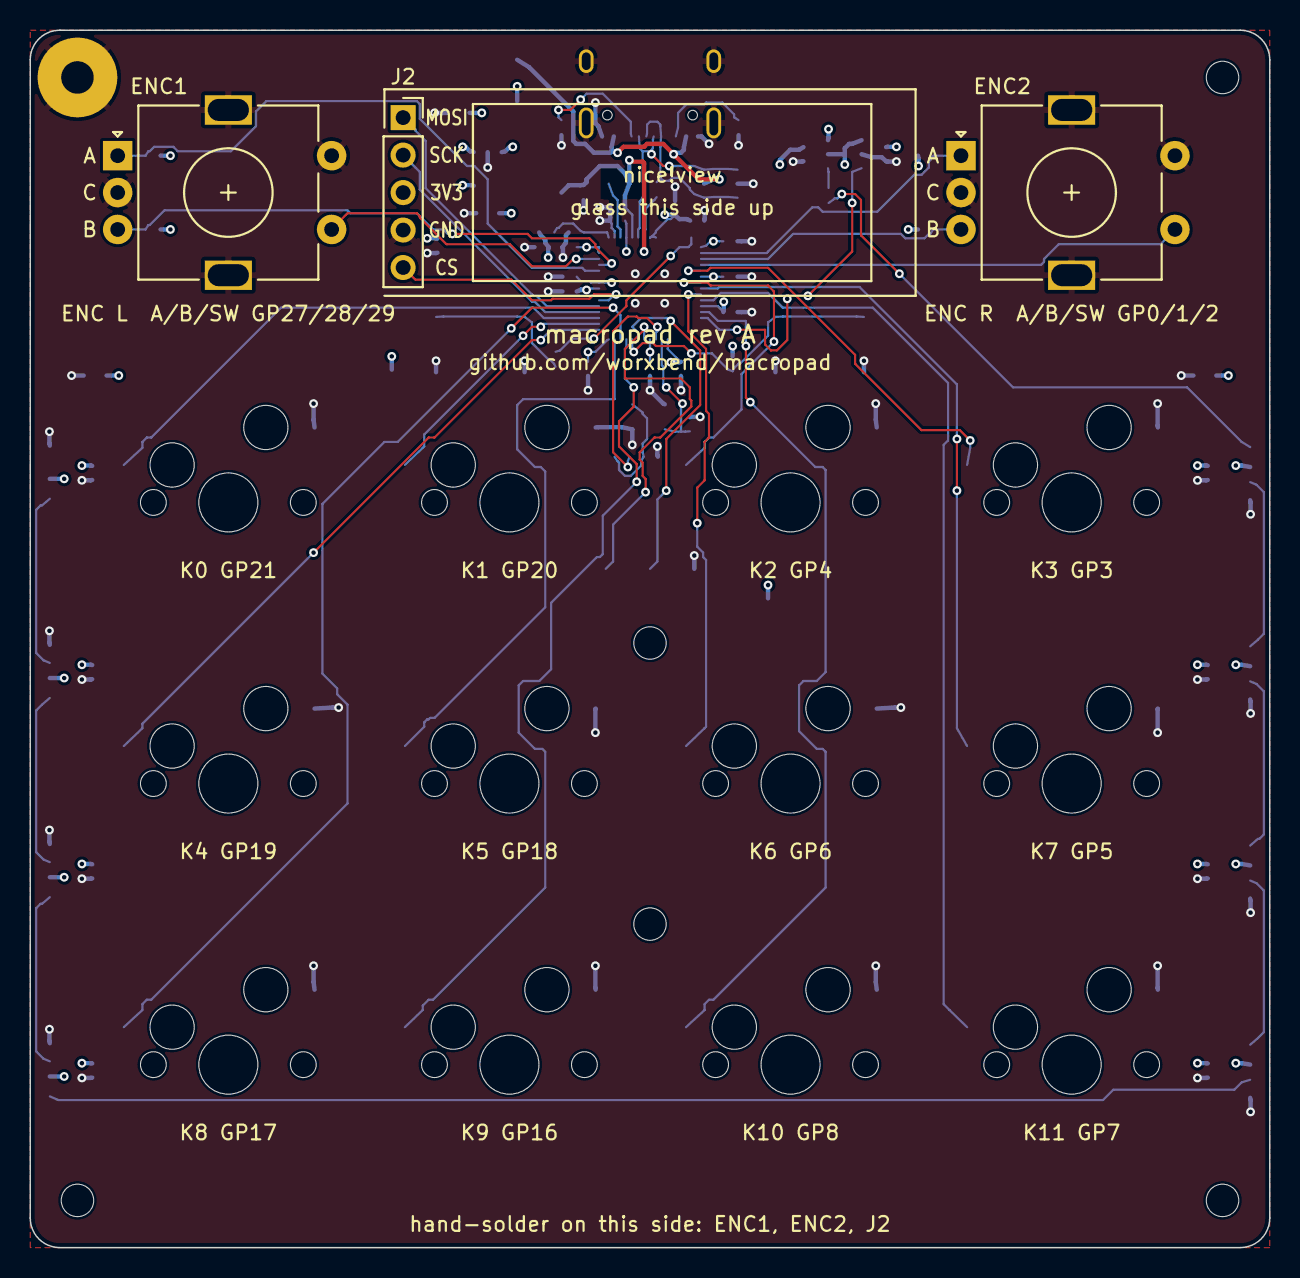
[picture p62: board macropad.kicad_pcb from above]

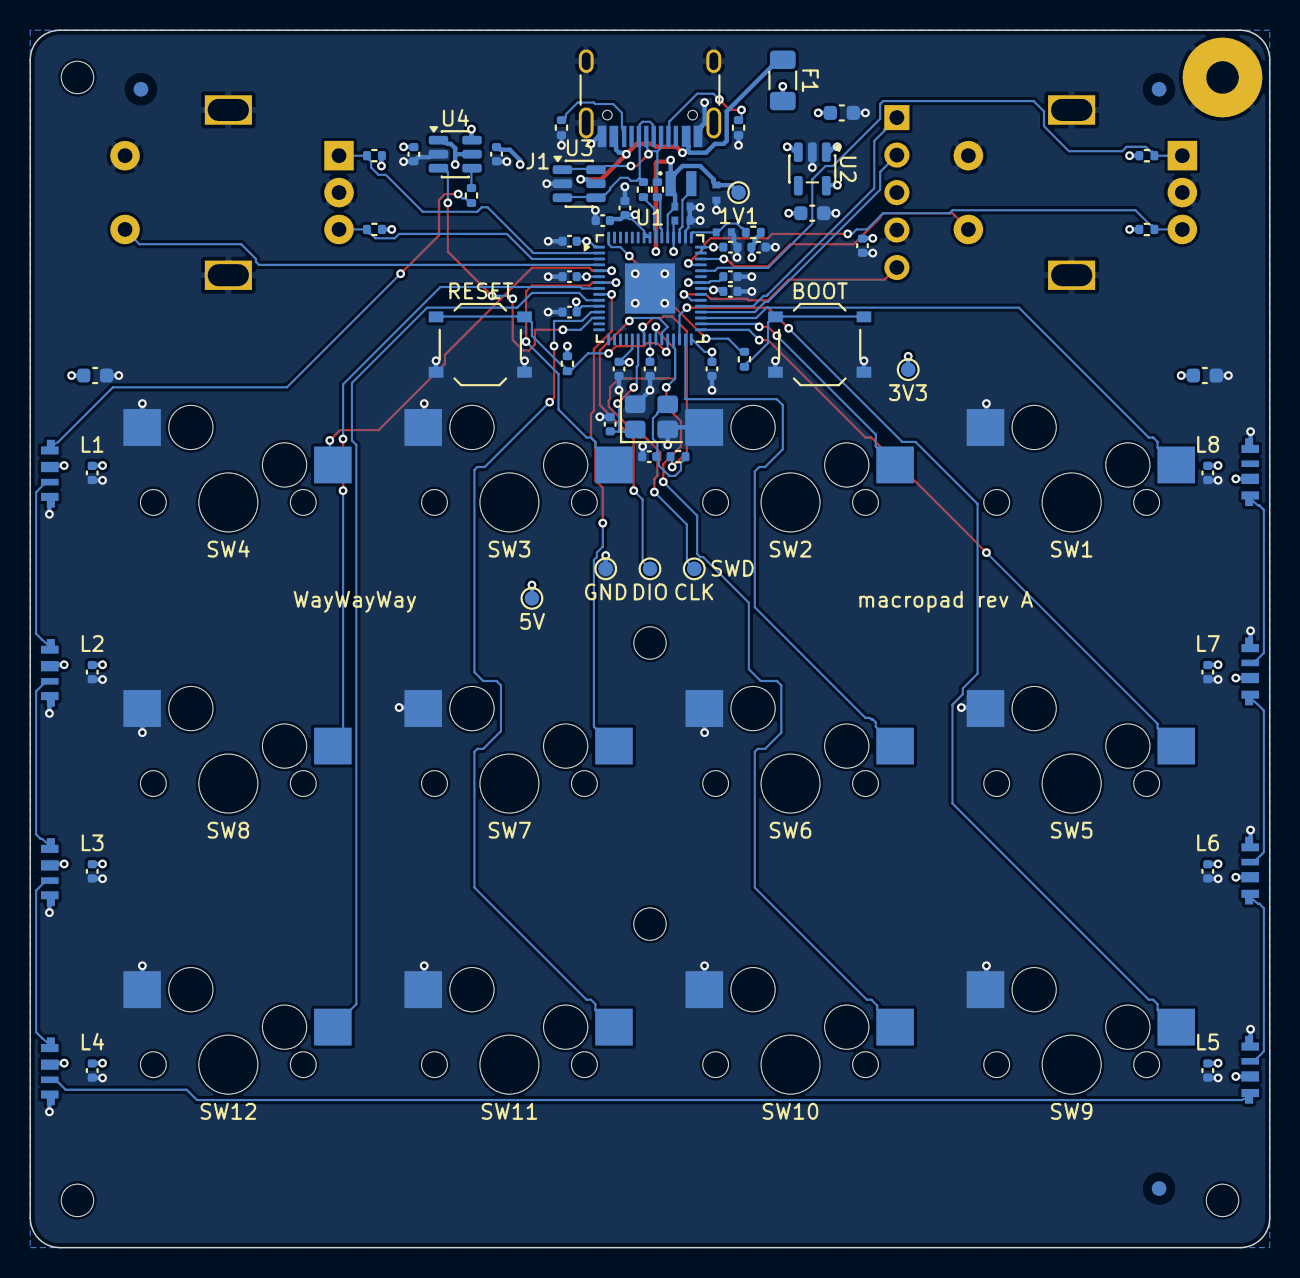
[picture p63: board macropad.kicad_pcb from below]

Board: 4 copper layers, 84.0 x 82.5 mm, 94 parts (85 on the bottom side), 52 nets.
