worxbend/macropad/firmware/core/src/font.rs

//! 5 x 7 pixel font for ASCII 0x20..=0x5F (digits, punctuation, capitals).

pub const GLYPH_WIDTH: usize = 5;
pub const GLYPH_HEIGHT: usize = 7;
/// Glyph width plus the one-pixel gap after it.
pub const ADVANCE: usize = GLYPH_WIDTH + 1;

const FIRST_CHAR: u8 = 0x20;
const UNKNOWN: u8 = b'?';

/// One byte per column, left to right; bit 0 is the top row.
#[rustfmt::skip]
const GLYPHS: [[u8; GLYPH_WIDTH]; 64] = [
    [0x00, 0x00, 0x00, 0x00, 0x00], [0x00, 0x00, 0x5F, 0x00, 0x00], [0x00, 0x07, 0x00, 0x07, 0x00], [0x14, 0x7F, 0x14, 0x7F, 0x14],
    [0x24, 0x2A, 0x7F, 0x2A, 0x12], [0x23, 0x13, 0x08, 0x64, 0x62], [0x36, 0x49, 0x55, 0x22, 0x50], [0x00, 0x05, 0x03, 0x00, 0x00],
    [0x00, 0x1C, 0x22, 0x41, 0x00], [0x00, 0x41, 0x22, 0x1C, 0x00], [0x14, 0x08, 0x3E, 0x08, 0x14], [0x08, 0x08, 0x3E, 0x08, 0x08],
    [0x00, 0x50, 0x30, 0x00, 0x00], [0x08, 0x08, 0x08, 0x08, 0x08], [0x00, 0x60, 0x60, 0x00, 0x00], [0x20, 0x10, 0x08, 0x04, 0x02],
    [0x3E, 0x51, 0x49, 0x45, 0x3E], [0x00, 0x42, 0x7F, 0x40, 0x00], [0x42, 0x61, 0x51, 0x49, 0x46], [0x21, 0x41, 0x45, 0x4B, 0x31],
    [0x18, 0x14, 0x12, 0x7F, 0x10], [0x27, 0x45, 0x45, 0x45, 0x39], [0x3C, 0x4A, 0x49, 0x49, 0x30], [0x01, 0x71, 0x09, 0x05, 0x03],
    [0x36, 0x49, 0x49, 0x49, 0x36], [0x06, 0x49, 0x49, 0x29, 0x1E], [0x00, 0x36, 0x36, 0x00, 0x00], [0x00, 0x56, 0x36, 0x00, 0x00],
    [0x08, 0x14, 0x22, 0x41, 0x00], [0x14, 0x14, 0x14, 0x14, 0x14], [0x00, 0x41, 0x22, 0x14, 0x08], [0x02, 0x01, 0x51, 0x09, 0x06],
    [0x32, 0x49, 0x79, 0x41, 0x3E], [0x7E, 0x11, 0x11, 0x11, 0x7E], [0x7F, 0x49, 0x49, 0x49, 0x36], [0x3E, 0x41, 0x41, 0x41, 0x22],
    [0x7F, 0x41, 0x41, 0x22, 0x1C], [0x7F, 0x49, 0x49, 0x49, 0x41], [0x7F, 0x09, 0x09, 0x09, 0x01], [0x3E, 0x41, 0x49, 0x49, 0x7A],
    [0x7F, 0x08, 0x08, 0x08, 0x7F], [0x00, 0x41, 0x7F, 0x41, 0x00], [0x20, 0x40, 0x41, 0x3F, 0x01], [0x7F, 0x08, 0x14, 0x22, 0x41],
    [0x7F, 0x40, 0x40, 0x40, 0x40], [0x7F, 0x02, 0x0C, 0x02, 0x7F], [0x7F, 0x04, 0x08, 0x10, 0x7F], [0x3E, 0x41, 0x41, 0x41, 0x3E],
    [0x7F, 0x09, 0x09, 0x09, 0x06], [0x3E, 0x41, 0x51, 0x21, 0x5E], [0x7F, 0x09, 0x19, 0x29, 0x46], [0x46, 0x49, 0x49, 0x49, 0x31],
    [0x01, 0x01, 0x7F, 0x01, 0x01], [0x3F, 0x40, 0x40, 0x40, 0x3F], [0x1F, 0x20, 0x40, 0x20, 0x1F], [0x3F, 0x40, 0x38, 0x40, 0x3F],
    [0x63, 0x14, 0x08, 0x14, 0x63], [0x07, 0x08, 0x70, 0x08, 0x07], [0x61, 0x51, 0x49, 0x45, 0x43], [0x00, 0x7F, 0x41, 0x41, 0x00],
    [0x02, 0x04, 0x08, 0x10, 0x20], [0x00, 0x41, 0x41, 0x7F, 0x00], [0x04, 0x02, 0x01, 0x02, 0x04], [0x40, 0x40, 0x40, 0x40, 0x40],
];

/// Column bitmaps of a character. Lowercase letters use the capitals; anything else unknown shows `?`.
pub fn glyph(character: char) -> [u8; GLYPH_WIDTH] {
    let upper = character.to_ascii_uppercase();
    let code = if upper.is_ascii() { upper as u8 } else { UNKNOWN };
    let index = code
        .checked_sub(FIRST_CHAR)
        .map(usize::from)
        .filter(|&index| index < GLYPHS.len());
    GLYPHS[index.unwrap_or(usize::from(UNKNOWN - FIRST_CHAR))]
}

/// Width of a string in pixels, without the gap after the last glyph.
pub fn text_width(text: &str) -> usize {
    (text.chars().count() * ADVANCE).saturating_sub(1)
}

/// Width of a string drawn with `Framebuffer::big_text`.
pub fn big_text_width(text: &str, scale: usize) -> usize {
    text_width(text) * scale
}

#[cfg(test)]
mod tests {
    use super::*;

    #[test]
    fn capital_i_is_a_centred_bar_with_serifs() {
        assert_eq!(glyph('I'), [0x00, 0x41, 0x7F, 0x41, 0x00]);
    }

    #[test]
    fn lowercase_uses_the_capital_glyph() {
        assert_eq!(glyph('a'), glyph('A'));
    }

    #[test]
    fn characters_outside_the_table_show_a_question_mark() {
        for outside in ['\n', '~', 'é', '\u{1F600}'] {
            assert_eq!(glyph(outside), glyph('?'), "{outside:?}");
        }
    }

    #[test]
    fn table_edges_are_reachable() {
        assert_eq!(glyph(' '), [0; GLYPH_WIDTH]);
        assert_eq!(glyph('_'), [0x40; GLYPH_WIDTH]);
    }

    #[test]
    fn text_width_has_no_trailing_gap() {
        assert_eq!(text_width(""), 0);
        assert_eq!(text_width("A"), 5);
        assert_eq!(text_width("AB"), 11);
    }

    #[test]
    fn big_text_width_scales_the_gaps_too() {
        assert_eq!(big_text_width("AB", 3), 33);
    }
}
