worxbend/macropad/firmware/core/src/lib.rs

//! Hardware-independent logic of the macropad. Everything here runs and is tested on a PC.
#![cfg_attr(not(test), no_std)]

pub mod activity;
pub mod debounce;
pub mod engine;
pub mod font;
pub mod framebuffer;
pub mod geometry;
pub mod hardware_test;
pub mod hid;
pub mod keymap;
pub mod kps;
pub mod led;
pub mod lighting;
pub mod pad;
pub mod quadrature;
pub mod reset;
pub mod sharp_lcd;
pub mod ui;
