worxbend/macropad/(commit log)

2026-11-12 Add macropad design: PCB generator, case, firmware
    A 12-key macropad on a custom 4-layer PCB: RP2354A, two EC11 encoders,
    a nice!view display, eight side-emitting RGB LEDs, one USB-C port.
    board.toml holds positions and GPIOs. The KiCad board, the build123d
    case and the firmware pin check all read it.
    The board is placed but not routed: the autorouter step (make pcb-route)
    still has to run, so there are no Gerbers yet. Nothing has been
    fabricated, printed or run on hardware.
    [assembly.step, base.step, base.stl, bom-jlcpcb.csv, diffuser.step, diffuser.stl, knob.step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]
2026-11-13 Route the board in code, add schematic, detail the case and firmware
    PCB: own router replaces Freerouting. Board is fully routed, DRC clean at
    every severity, with a KiCad schematic checked pin by pin against circuit.py.
    Gerbers, drill files, BOM and placement list are generated and cross-checked.
    Case: drawings, tilt bar, print simulation and a self-test of the checks.
    Firmware: UI split into screens, HID descriptor check, more engine tests.
    Docs: assembly guide, updated hardware and parts notes. CI runs the checks
    that need neither Docker nor hardware.
    Not built on hardware. Open before ordering: crystal load capacitors,
    31 uF on VBUS, shared decoupling on QSPI_IOVDD and ADC_AVDD.
    [assembly.step, base.step, base.stl, diffuser.step, diffuser.stl, engraving_top.dxf, engraving_underside.dxf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]
2026-11-13 Fix the three open electrical points, make CI pass on a fresh checkout
    Crystal: X322512MMB4SI (C50430), 10 pF load like the reference part, so the
    15 pF capacitors and 1 k series resistor are the reference values again.
    5 V rail: C17, C22 and C23 go from 10 uF to 2.2 uF. About 7.5 uF now sits
    behind the fuse; USB allows 10 uF at plug-in.
    Decoupling: ADC_AVDD and QSPI_IOVDD each get their own 100 nF (C32, C33).
    Neither fits in front of its pin; the PCB README says where they sit.
    Board rerouted: 797 tracks, 160 vias, 0 unrouted, DRC and ERC clean,
    71 machine-placed parts in 22 BOM lines.
    check_docs no longer demands build output (cad/.venv, pcb/.build) that a
    fresh checkout does not have; t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
    [bom-jlcpcb.csv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]
2026-11-13 WIP: case redesign in progress
    Snapshot taken while the case code is being rewritten. Unfinished and
    unchecked: the case checks may fail and the exports and renders may not
    match the code. Do not print or mill from this commit; use v0.1.0.
    [assembly.step, base.step, base.stl, centre_pad.step, centre_pad.stl, diffuser.step, diffuser.stl, engraving_top.dxf]
2026-11-13 WIP: add the signature engraving to the base underside
    A single-line signature (34 x 24 mm, groove 0.6 mm wide, 0.3 mm deep) and a
    "Signature Edition" caption, cut into the floor of both variants beside the
    centre pad. Three new checks: floor left under the groove, artwork inside its
    free field, groove no narrower than a mill can cut.
    Not verified: the case checks were still running when this was committed, and
    the case redesign around it is unfinished. Exports and renders do not show
    the engraving yet.
    [engraving_top.dxf, engraving_underside.dxf, lens.dxf, lens_mask.dxf]
2026-11-13 WIP: signature engraving on the CNC base only, case checks pass
    The printed base has no signature: printed underside down, the winding groove
    counts as one 24 mm unsupported span. The 3 mm end-mill checks measure the
    base before the engraving, as they already do for printed text; the engraving
    is a second operation with its own three checks.
    Case checks: 23 of 23 self-tests, 582 pairs and 0 clashes in both variants,
    no failures. Includes the unfinished case redesign; exports and renders do
    not show the engraving yet.
2026-11-13 WIP: signature reads "Oleksandr B" and is laser-marked, not milled
    The signature is flat artwork now: nothing is cut into the base, so the solids,
    STEP and STL files do not contain it and the mill checks measure the whole
    base again. The line reads "Oleksandr B" in one joined hand, 34 x 19 mm,
    0.3 mm wide, with the caption "Signature Edition" under it. The laser shop
    gets cad/exports/drawings/engraving_underside.dxf, drawn at its place on the
    underside as seen from above.
    no failures. Includes the unfinished case redesign; renders may still show
    the earlier milled groove.
    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
    [assembly.step, base.step, base.stl, centre_pad.step, diffuser.step, engraving_top.dxf, engraving_underside.dxf, foot_strip.step]
2026-11-13 WIP: redesigned case built in both variants, renders and docs updated
    Build step of the case redesign is done: make cad, make test and make
    docs-check pass (23 of 23 self-tests, 582 pairs and 0 clashes per variant, no
    failing row). New renders, including the milled underside with the
    laser-marked signature. Review rounds are still to come; nothing has been
    printed, milled or cut.
    [assembly.step, base.step, base.stl, centre_pad.step, diffuser.step, foot_strip.step, knob.step, lens.step]
2026-11-13 Regenerate case drawings and DXF artwork after the redesign build
    [engraving_top.dxf, engraving_underside.dxf, lens.dxf, lens_mask.dxf]
2026-11-13 WIP: first review fix round of the case redesign, in progress
    Snapshot taken while the fix agent is still editing the case code.
    Unchecked: the case checks may fail and the exports and renders may not
    match the code. Use b5303f6 or v0.1.0 for anything you print or mill.
2026-11-13 Add a microsite for GitHub Pages
    site/ holds one page: what the pad is, the case renders, the laser-marked
    signature, the board, the firmware, the specs and the four build steps, with a
    plain note that nothing has been built. make site copies the pictures the page
    names from docs/images/ into _site/ and fails on a missing one, so the site
    always shows the renders of its own commit. CI runs it; pages.yml publishes
    _site/ on every push to main.
    Also carries the case redesign's fix round as it stands (WIP).
2026-11-13 WIP: case redesign after review round 2, second fix round interrupted
    Snapshot after the PC reset during the second fix round. The first fix
    round and the second round of critics finished; the second fix round was
    cut off part way. Unchecked: case checks, exports and renders may disagree.
    [assembly.step, base.step, base.stl, centre_pad.step, centre_pad.stl, diffuser.step, diffuser.stl, engraving_top.dxf]
2026-11-13 WIP: case redesign fix round 2 and product site build, both in progress
    Snapshot while two workflows are still editing: the case redesign's second
    fix round (cad/, docs/) and the new product page (site/, build script).
    Unchecked: case checks, exports, renders and the site may disagree.
    [assembly.step, base.step, base.stl, centre_pad.step, diffuser.step, diffuser.stl, engraving_underside.dxf, foot_strip.step]
2026-11-13 Regenerate case drawings after the redesign's last fix round
    The case redesign workflow is done: 31 of 31 self-tests, 659 pairs and 0
    clashes per variant, no failing row, docs in line with the as-built model.
    Nothing has been printed or milled.
    [engraving_underside.dxf, lens.dxf, lens_mask.dxf]
2026-11-13 Product page for GitHub Pages: scroll-told, animated, with the signature
    A launch-style page built around the case's one line: hero zoom, word-by-word
    intro, the seam reaching out of the side render, the light line coming on in
    the dark, a colourway switcher, the exploded view, the board flip, a firmware
    screen scrubber, use cases per layer, specs, status and build steps. The
    signature is drawn stroke by stroke from cad/macropad_case/signature.py and
    lands on the milled base render. Every render in docs/images is shown or
    skipped with a reason; the build fails otherwise, and on a broken link, a
    wrong image size, a skipped heading level or a missing signature. Motion is
    vanilla JS, turned off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
2026-11-14 WIP: PCB order fixes in progress (L1 polarity, crystal, regulator layout)
    Snapshot after the PC shut down mid-run. The board was last placed with 2
    unrouted ground pads at J1, so these board files do not pass DRC. Do not
    order from this commit; use v0.1.0.
    [macropad.kicad_pcb, macropad.kicad_sch]
2026-11-14 Order fixes: PCB, CNC case files and drawings ready for quotes
    PCB (make pcb-place / pcb-check / pcb-fab: 0 DRC, 0 unconnected, 0 parity):
    1. L1 pad 1 = +1V1, Raspberry Pi AOTA footprint, dot assert in placement check.
    2. Crystal C20625731 (Abracon ABM8-272-T3).
    3. 1.1 V regulator laid out to the Raspberry Pi reference; FB 2.29 mm, LX 3.91 mm.
    4. R9 330 ohm on the LED data line; silk text 1.0 mm.
    5. CPL at body centre (J1, LEDs); new PCBWay BOM with MPNs; sourcing checks.
    CNC case (make cad: 31/31 self-tests, 0 clashes, 0 FAIL):
    1. base.step open shell fixed (offset curves rebuilt as B-splines).
    2. New STEP/STL read-back check in build.py export.
    3. Display on a soldered C2337 header, glass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
    [assembly.step, base.step, base.stl, bom-jlcpcb.csv, bom-pcbway.csv, centre_pad.step, centre_pad.stl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]
2026-11-14 PCB: LX keepout follows the routed track, silk minimums, 4.7 uF at pin 23
    1. VREG_LX keepouts are built from the routed track after routing. New
    check_no_pour_under_regulator reads the filled board: it fails on the
    previous board (GND on F.Cu at 39.80, 13.30) and passes now.
    2. Footprint silkscreen raised to 1.0 mm text / 0.15 mm lines in the
    generator; silk.check_minimums asserts it on the whole board.
    3. C5 at DVDD pin 23 is now 4.7 uF (RP2350 datasheet 6.1.3); C13 stays as
    an extra. BOM: 24 lines, 72 parts.
    4. R4 stays by the BOOT button: a third try beside pin 60 blocked KEY4,
    KEY8 and DISP_CS and overlapped U3. Recorded in pcb/README.md.
    5. Measurement checklist for every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
    [bom-jlcpcb.csv, bom-pcbway.csv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]
2026-11-14 Prototype ready: PCBWay order files, bring-up firmware, case fixes, plan
    Review before the first prototype order. Accepted decisions: PCBWay
    turnkey assembly of the bottom face, ground plane next to the parts,
    case bonded to GND at H1, 3.3k encoder pull-ups, LED suspend current
    accepted for the prototype.
    PCB
    1. GND moved to In2.Cu, next to B.Cu where the parts and 1067 of 1308 mm
    of track are; the 5 V plane and its 3V3 and 1V1 islands on In1.Cu.
    2. R10-R13: 3.3k pull-ups on the encoder A/B lines (Alps: 1 mA minimum
    contact current; internal pull-ups give about 0.05 mA).
    3. C13 do-not-populate: COUT must be 4.7 uF +/-20 % (RP2350 datasheet
    6.3.8); C5 at DVDD pin 23 is the second 4.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
    [assembly.step, base.step, base.stl, bom-jlcpcb.csv, bom-pcbway.csv, centre_pad.step, centroid-pcbway.csv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]
